RodeanAzari/riscv-rv32i-tmr-core/docs/reports/ila_coremark.csv

Sample in Buffer | Sample in Window | TRIGGER | g_ila.ex_mem_alu_result_p[31:0] | g_ila.ex_mem_instr_p[31:0] | g_ila.ex_mem_pc_p[31:0] | g_ila.halt_p | g_ila.id_ex_instr_p[31:0] | g_ila.id_ex_pc_p[31:0] | g_ila.if_id_instr_p[31:0] | g_ila.if_id_pc_p[31:0] | g_ila.mem_wb_instr_p[31:0] | g_ila.mem_wb_pc_p[31:0] | g_ila.wb_rd_addr_p[4:0] | g_ila.wb_rd_wdata_p[31:0] | g_ila.wb_rd_we_p
Radix - UNSIGNED | UNSIGNED | UNSIGNED | HEX | HEX | HEX | HEX | HEX | HEX | HEX | HEX | HEX | HEX | HEX | HEX | HEX
0 | 0 | 0 | 00004b78 | 00044783 | 00002574 | 0 | 00000013 | 00000000 | 0007a023 | 0000255c | fed796e3 | 00002570 | 0d | ffffffec | 0
1 | 1 | 0 | 00000000 | 00000013 | 00000000 | 0 | 0007a023 | 0000255c | 00072023 | 00002560 | 00044783 | 00002574 | 0f | 00004b78 | 0
2 | 2 | 0 | 00007e74 | 0007a023 | 0000255c | 0 | 00072023 | 00002560 | 00478793 | 00002564 | 00000013 | 00000000 | 00 | 00000000 | 1
3 | 3 | 0 | 00007e54 | 00072023 | 00002560 | 0 | 00478793 | 00002564 | 05010693 | 00002568 | 0007a023 | 0000255c | 00 | 00007e74 | 0
4 | 4 | 0 | 00007e78 | 00478793 | 00002564 | 0 | 05010693 | 00002568 | 00470713 | 0000256c | 00072023 | 00002560 | 00 | 00007e54 | 0
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
