RodeanAzari/riscv-rv32i-tmr-core/docs/reports/ila_capture.csv

Sample in Buffer | Sample in Window | TRIGGER | g_ila.ex_mem_alu_result_p[31:0] | g_ila.ex_mem_instr_p[31:0] | g_ila.ex_mem_pc_p[31:0] | g_ila.halt_p | g_ila.id_ex_instr_p[31:0] | g_ila.id_ex_pc_p[31:0] | g_ila.if_id_instr_p[31:0] | g_ila.if_id_pc_p[31:0] | g_ila.mem_wb_instr_p[31:0] | g_ila.mem_wb_pc_p[31:0] | g_ila.wb_rd_addr_p[4:0] | g_ila.wb_rd_wdata_p[31:0] | g_ila.wb_rd_we_p
Radix - UNSIGNED | UNSIGNED | UNSIGNED | HEX | HEX | HEX | HEX | HEX | HEX | HEX | HEX | HEX | HEX | HEX | HEX | HEX
0 | 0 | 0 | 00251f06 | 00178793 | 00000210 | 0 | 00f12623 | 00000214 | 00c12783 | 00000218 | 00178793 | 00000210 | 0f | 00007fcd | 0
1 | 1 | 0 | 00007fcc | 00f12623 | 00000214 | 0 | 00c12783 | 00000218 | fefb78e3 | 0000021c | 00178793 | 00000210 | 0f | 00251f06 | 1
2 | 2 | 0 | 00007fcc | 00c12783 | 00000218 | 0 | fefb78e3 | 0000021c | fefb78e3 | 0000021c | 00f12623 | 00000214 | 0c | 00007fcc | 0
3 | 3 | 0 | fffffff0 | fefb78e3 | 0000021c | 0 | fefb78e3 | 0000021c | 001c0c13 | 00000220 | 00c12783 | 00000218 | 0f | 00251f06 | 1
4 | 4 | 0 | fffffff0 | fefb78e3 | 0000021c | 0 | 001c0c13 | 00000220 | 00000013 | 00000000 | fefb78e3 | 0000021c | 11 | fffffff0 | 0
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
