RodeanAzari/riscv-rv32i-tmr-core/docs/img/vivado/phase-d/90-102.png

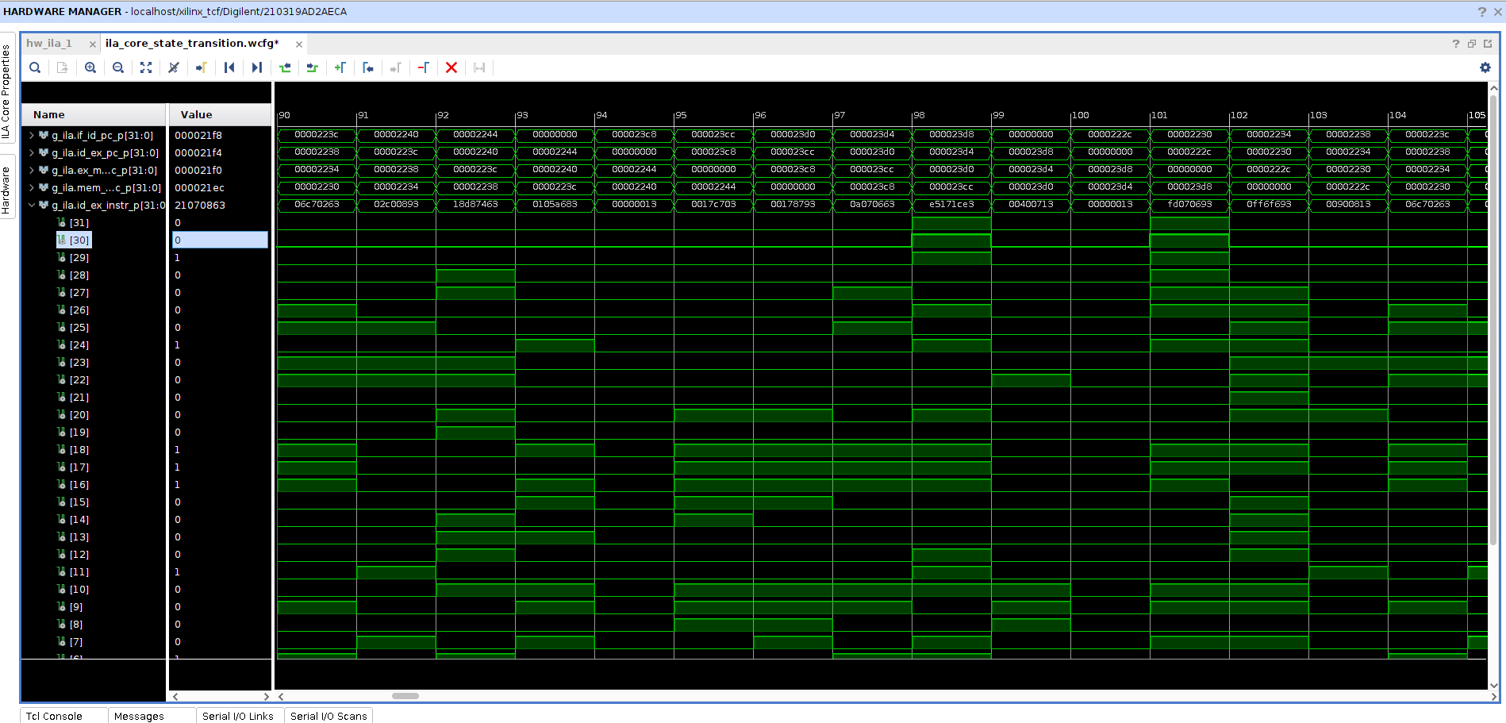
docs/img/vivado/phase-d/90-102.png
