RodeanAzari/riscv-rv32i-tmr-core/docs/img/vivado/phase-d/rtl-schematic-1.png

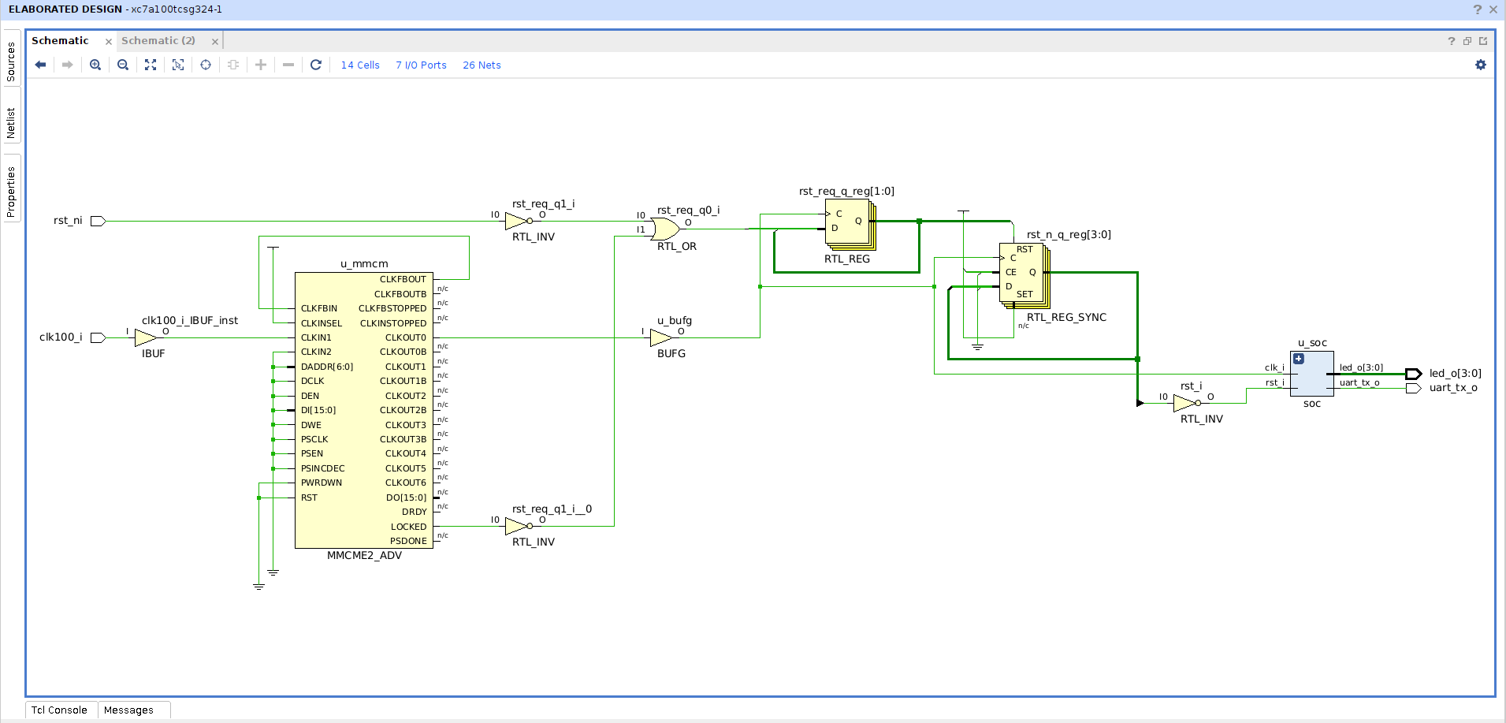
docs/img/vivado/phase-d/rtl-schematic-1.png
