RodeanAzari/riscv-rv32i-tmr-core/docs/img/vivado/phase-d/rtl-schematic-core-doubleclick.png

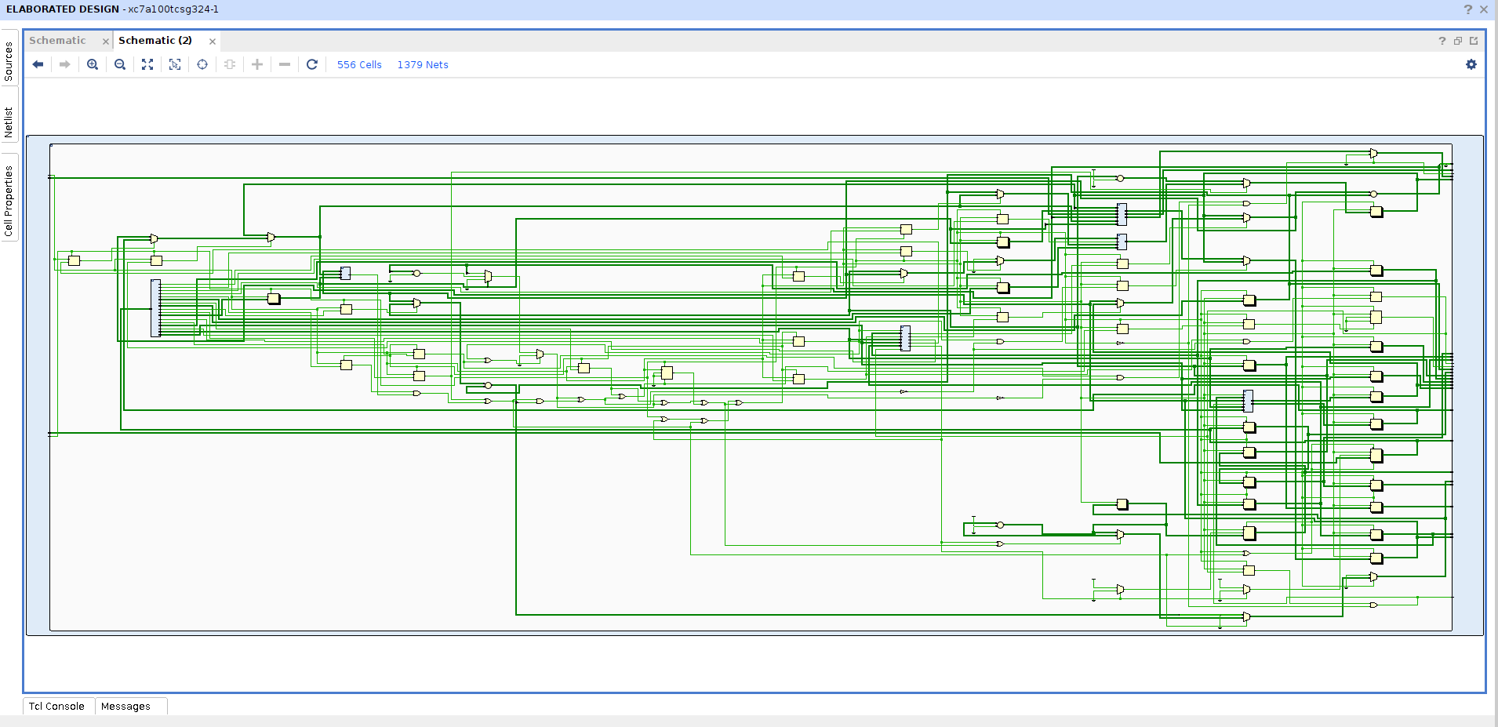
docs/img/vivado/phase-d/rtl-schematic-core-doubleclick.png
