RodeanAzari/riscv-rv32i-tmr-core/docs/img/vivado/phase-d/rtl-schematic-ram.png

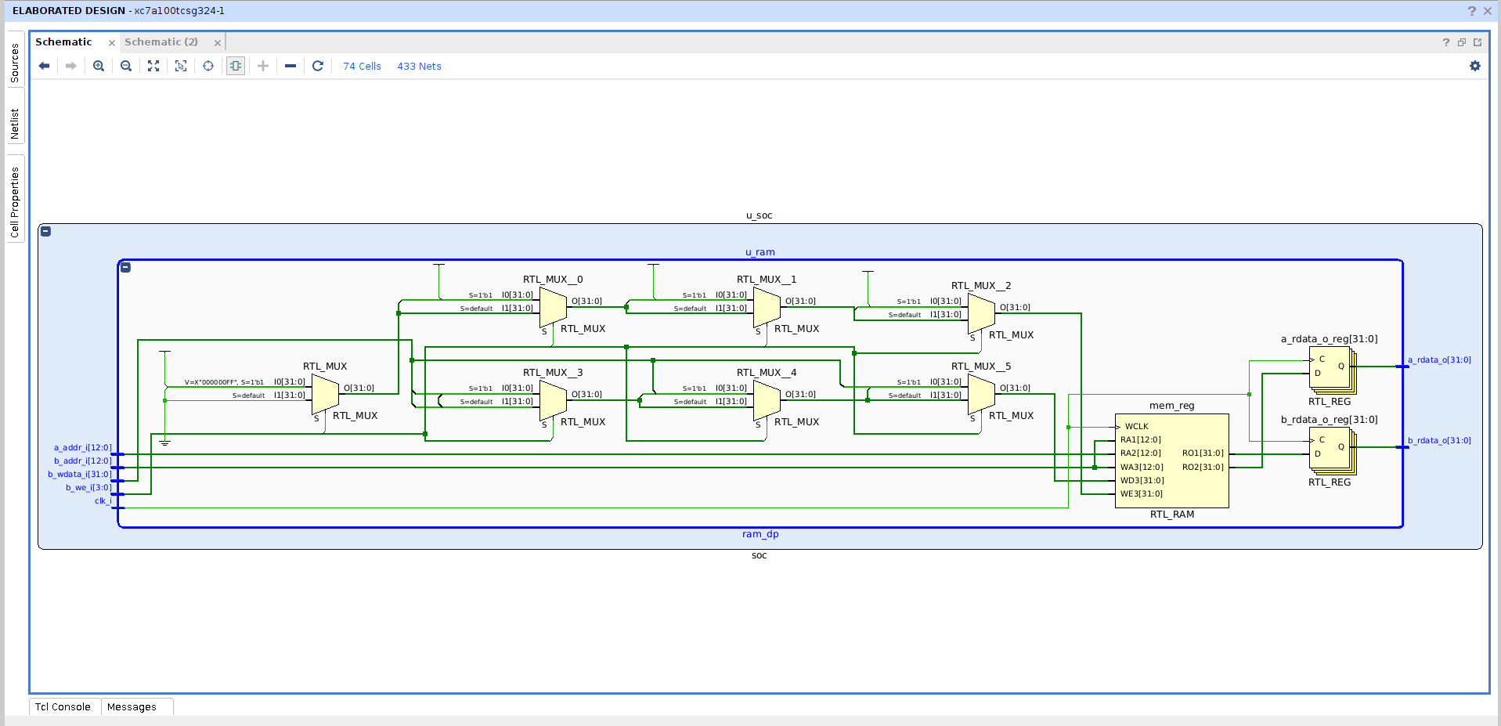
docs/img/vivado/phase-d/rtl-schematic-ram.png
