RodeanAzari/riscv-rv32i-tmr-core/docs/img/vivado/phase-d/rtl-schematic-u_soc.png

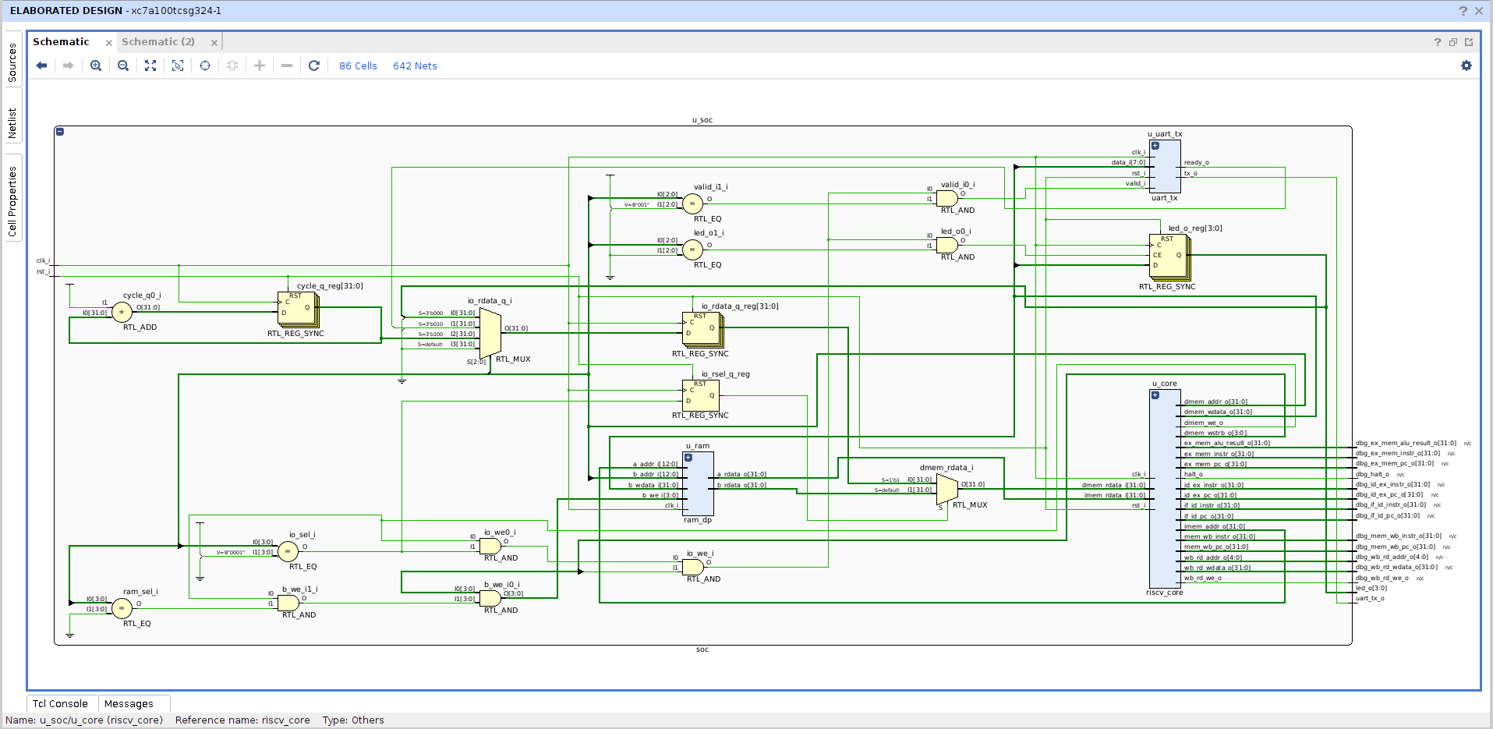
docs/img/vivado/phase-d/rtl-schematic-u_soc.png
