RodeanAzari/riscv-rv32i-tmr-core/docs/img/vivado/phase-d/utilization-summary.png

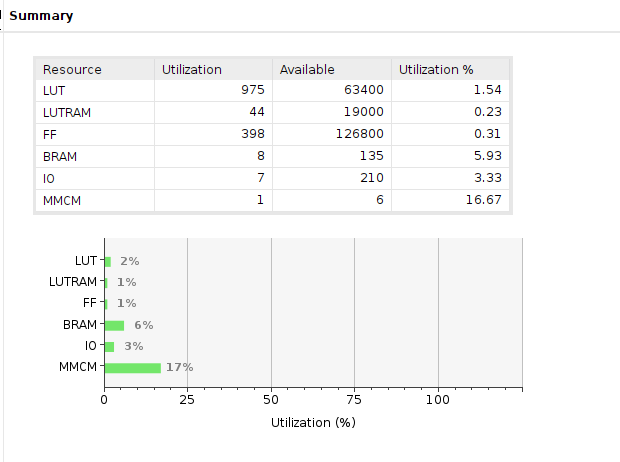
docs/img/vivado/phase-d/utilization-summary.png
