RodeanAzari/riscv-rv32i-tmr-core/docs/buildplan.md

# Build Plan

Reference spec for the project, moved out of `CLAUDE.md` so it is not loaded on
every request. **Section numbers are unchanged** (§5 to §8, plus the lists from
§9 and §10), because other docs cite them (§5.5, §6.4, §6.5...). Read the
relevant section when starting a phase; do not load the whole file.

## 5. Stage 1 specification

### 5.1 ISA

**RV32I base integer set**, 40 instructions:
- `LUI` `AUIPC` `JAL` `JALR`
- `BEQ` `BNE` `BLT` `BGE` `BLTU` `BGEU`
- `LB` `LH` `LW` `LBU` `LHU`
- `SB` `SH` `SW`
- `ADDI` `SLTI` `SLTIU` `XORI` `ORI` `ANDI` `SLLI` `SRLI` `SRAI`
- `ADD` `SUB` `SLL` `SLT` `SLTU` `XOR` `SRL` `SRA` `OR` `AND`
- `FENCE` `ECALL` `EBREAK`

**Out of scope:** M/A/F/D/C extensions, CSRs beyond a basic timer, MMU, privilege modes, interrupts.
*Changed 2026-10-22: the M extension is now planned for after Phase G (see Phase H), to speed up the tiny-LLM demo and Doom. A/F/D/C remain out of scope.*

### 5.2 Pipeline

Classic 5-stage in-order:

| Stage | Function |
|---|---|
| **IF** | PC update, instruction fetch from BRAM |
| **ID** | Decode, regfile read, immediate generation, hazard detection |
| **EX** | ALU, branch resolution, forwarding muxes |
| **MEM** | Data memory access, load/store alignment |
| **WB** | Regfile writeback |

**Branch resolution in EX.** Static not-taken prediction; flush IF/ID and ID/EX on taken.

### 5.3 Forwarding and hazards

Required paths:
- **EX→EX** (ALU result to next instruction's operand)
- **MEM→EX**
- **WB→ID** (regfile internal forwarding — write-first behaviour)

**Load-use hazard requires a one-cycle stall.** Forwarding cannot fix it because the load result isn't available until MEM. This is the single most commonly botched case — write directed tests for it before trusting random stimulus.

`x0` must always read zero regardless of writes.

### 5.4 RVFI interface (required for Phase B)

The core **must expose a RISC-V Formal Interface (RVFI) port** for `riscv-formal`. Design this in from Phase A — retrofitting it is painful.

Minimum signals: `rvfi_valid`, `rvfi_order`, `rvfi_insn`, `rvfi_trap`, `rvfi_halt`, `rvfi_intr`, `rvfi_rs1_addr`, `rvfi_rs2_addr`, `rvfi_rs1_rdata`, `rvfi_rs2_rdata`, `rvfi_rd_addr`, `rvfi_rd_wdata`, `rvfi_pc_rdata`, `rvfi_pc_wdata`, `rvfi_mem_addr`, `rvfi_mem_rmask`, `rvfi_mem_wmask`, `rvfi_mem_rdata`, `rvfi_mem_wdata`.

Emitted at the WB stage, one retirement per `rvfi_valid`.

### 5.5 Formal properties (Phase B)

Beyond riscv-formal's ISA compliance, hand-write SVA for:

- **Forwarding correctness** — forwarded value equals the architectural value the instruction should have read
- **No structural hazard** on regfile read/write ports
- **Branch flush correctness** — no wrong-path instruction ever reaches WB
- **Pipeline register validity** — no X propagation into committed architectural state
- **`x0` invariance** — reads as zero always
- **Stall correctness** — a stalled stage holds its value; no instruction is lost or duplicated

Run bounded model checking **and induction**. Check every property for **reachability** — a property that passes vacuously proves nothing. Record proof depth.

**Log every bug formal catches that simulation missed.** This is the highest-value artifact of the phase.

### 5.6 UVM environment (Phase C)

- Driver, monitor, scoreboard, coverage collector
- Golden ISA reference model (C++ or Python) via **DPI-C**
- Per-instruction architectural state comparison against the model
- Constrained-random instruction stream generation

**Functional coverage plan** (write it in `docs/` first, then close against it):
- All 40 instructions
- All forwarding paths, individually and in combination
- Load-use stall
- Branch taken / not-taken for each branch type
- Corner immediates (0, max positive, max negative, sign-extension boundaries)
- Back-to-back dependent instructions
- Memory alignment cases for each load/store width

**Target: ≥95% functional coverage.**

### 5.7 TMR (Phase E)

```
   ┌──────────────┐
──▶│  Core Copy A │──┐
   └──────────────┘  │
   ┌──────────────┐  │   ┌─────────────┐
──▶│  Core Copy B │──┼──▶│    VOTER    │──▶ output
   └──────────────┘  │   │  (2-of-3)   │
   ┌──────────────┐  │   └──────┬──────┘
──▶│  Core Copy C │──┘          │
   └──────────────┘             ▼
                          mismatch counter
```

- Vote on **architectural state**: regfile writes, PC, memory writes
- Expose a **mismatch counter** readable at runtime
- **Fault-injection harness** (testbench only, not synthesizable): flip random bits in regfile/pipeline registers at randomized cycles
- **Formally verify the voter**: any two agreeing inputs produce that output

Measure: fault detection rate, recovery rate, area overhead vs. baseline, Fmax penalty.

⚠ **Use `DONT_TOUCH` / `KEEP_HIERARCHY` on the three copies.** Vivado will otherwise merge identical logic and silently defeat the redundancy. Verify in the synthesis report that three copies actually exist.

---

## 6. Stage 2 specification

```
   ┌──────────────────┐        ┌──────────────────────────┐
   │  RISC-V CORE     │        │  SYSTOLIC ARRAY          │
   │  (Stage 1)       │        │  16×16 PE, INT8→INT32    │
   │  control code    │        │  weight-stationary       │
   └────────┬─────────┘        └────────────┬─────────────┘
            │ AXI4-Lite master              │ AXI4-Lite slave (ctrl)
            │                               │ AXI4 master (data)
   ┌────────▼───────────────────────────────▼─────────────┐
   │           AXI4 / AXI4-Lite INTERCONNECT              │
   │   round-robin arbiter · address decode · outstanding │
   └──────┬─────────────────┬─────────────────┬───────────┘
          │                 │                 │
   ┌──────▼──────┐  ┌───────▼──────┐  ┌───────▼────────┐
   │ DMA ENGINE  │  │ BRAM weights │  │ BRAM activations│
   │ descriptor  │  │  + scratchpad│  │  + results      │
   │ scatter-gath│  │              │  │                 │
   └─────────────┘  └──────────────┘  └─────────────────┘
```

### 6.1 Systolic array

**Weight-stationary**, 16×16 PE grid.

```
   weights preloaded into PEs and held
   activations stream left→right, partial sums flow top→bottom

   Each PE:  acc_out = acc_in + (w_stationary × a_in)
             a_out   = a_in   (registered, passes right)
```

| Parameter | Value | Rationale |
|---|---|---|
| Array size | 16×16 = 256 MACs | Parameterize it. 8×8 is the fallback. |
| Input precision | INT8 signed | — |
| Accumulator | INT32 | 16 terms × (±128)² ≈ 2^18; INT32 gives ample headroom |
| Dataflow | Weight-stationary | Simplest; good for GEMM with weight reuse |

**DSP budget.** 256 MACs vs. 240 DSP48E1. Two INT8 multiplies can be packed into one DSP48E1 by placing two 8-bit operands in the 25-bit A port with sufficient guard bits (see Xilinx WP487 — written for DSP48E2, adapt for the 25×18 DSP48E1).

**Verify packing empirically.** Check the synthesis report for actual DSP count. If Vivado maps MACs to LUT fabric instead, either restructure the code or instantiate `DSP48E1` explicitly. **If packing doesn't work out, drop to 8×8 rather than fighting it** — a working 8×8 with honest numbers beats a broken 16×16.

**Data feeding is the real problem.** A 16×16 array consumes 16 activations per cycle. Document BRAM banking and how the array stays fed. **Report measured PE utilization, not peak theoretical GOPS.** An honest 40% with an explanation is a better answer than a peak figure that can't be defended.

Also specify: edge handling for matrices not a multiple of 16 (zero-pad vs. partial-tile control), and output requantization (scale, saturation, rounding mode).

### 6.2 AXI interconnect

- **AXI4-Lite** for control registers (core → accelerator, core → DMA)
- **AXI4** for data movement
- Round-robin arbitration, address decode, outstanding-transaction tracking

**SVA protocol assertions required:**
- `VALID` must not deassert before `READY` (handshake stability)
- Address/data stable while `VALID` high and `READY` low
- No `READY`/`VALID` combinational dependency loop (deadlock freedom)
- Outstanding transaction count never exceeds the configured limit
- Write response follows write data

### 6.3 DMA engine

Descriptor-based with scatter-gather. **The register map and descriptor format are [DMA-Engine](https://github.com/RodeanAzari/DMA-Engine)'s** (submodule `sw/dma-engine/`, `spec/dmaeng.yaml`), so the driver built there against its QEMU model matches this RTL. That replaces the linked list first planned here (descriptors with a next pointer): descriptors sit in a power-of-two ring (32 bytes each: source, destination, length, flags with OWN/IRQ/LAST, status); the driver advances TAIL (the doorbell), the engine walks HEAD to TAIL, writes status before clearing OWN, and stops on an error until `CTRL.RESET`. Scatter-gather is a run of descriptors closed by `LAST`. Behaviour follows `qemu-device/dmaeng.c`; `traces/dmaeng-sync.trace` is golden stimulus.

On this SoC: addresses are 32 bits, so `RING_BASE_HI` and the descriptors' upper address words must be 0 (anything else fails as an unmapped access, `DMA_FAIL`). The core has no interrupts: `IRQ_STATUS`/`IRQ_MASK` and the interrupt output exist as specified, and software polls OWN or HEAD.

> **Design note:** this DMA is reused later for a PCIe host bridge. **Separate the descriptor/scatter-gather logic from the transport layer** so only the transport changes. Do not entangle AXI specifics into the descriptor engine.

### 6.4 ASIC flow (LibreLane + Sky130)

Not a separate project — it runs on this repo's RTL and its results belong in this README.

**LibreLane, not OpenLane.** LibreLane is the FOSSi Foundation's continuation of
Efabless's OpenLane 2; after Efabless wound down, OpenLane 2 went quiet and the original
OpenLane became the legacy flow. Same underlying tools (Yosys, OpenROAD, Magic, Netgen,
KLayout), same Sky130 PDK, same steps below. Older docs and tutorials say "OpenLane" —
read them as background, not as install or config instructions.

**This section spans both stages.** It sits in §6 to keep the ASIC story in one place,
but run #1 is a **Phase E deliverable and therefore part of Stage 1** — it is a checkbox
in Phase E's definition of done, so Stage 1 is not complete until it has been done.

**Run it twice:**

| Run | When | Input |
|---|---|---|
| **1** | Closing Phase E | Stage 1 bare core, non-TMR variant (smaller, simpler) |
| **2** | During Phase H | Full Stage 2 SoC with accelerator, DMA, AXI |

The **comparison between the two runs** is the interesting result — how area, congestion, and timing closure change when an accelerator and a bus fabric are added. That feedback loop (physical results informing RTL decisions) is more valuable than either run alone.

**Flow steps:**
1. Synthesis (Yosys)
2. **Scan chain insertion** (§6.5)
3. Floorplanning
4. Placement
5. Clock tree synthesis
6. Routing
7. STA signoff
8. DRC / LVS clean
9. GDSII output

**Report per run:** die area (µm²), cell count, utilization %, post-layout Fmax vs. pre-synthesis estimate, power estimate, DRC/LVS clean confirmation, layout screenshot.

Also write a short FPGA-vs-ASIC comparison for the same RTL — the two targets have very different cost models and saying why is a good interview answer.

### 6.5 Scan chain insertion (DFT)

Small addition during Phase H — budget 2–3 days.

**Achievable with free tools:**
- Scan chain insertion via Yosys/LibreLane — convert flops to scan flops, stitch chains.
  **Unverified:** whether LibreLane has a built-in scan-insertion step. Check before
  budgeting Phase H around it.
- Scan shift verification in simulation
- Report chain count, chain length, test coverage, area and timing overhead vs. non-scan

**Not achievable — do not attempt:** MBIST generation, commercial ATPG (Tessent, TetraMAX), SSN, boundary scan insertion. All require licensed tools.

**Framing:** "inserted and verified scan chains in an open-source ASIC flow, with coverage and area overhead reported" is truthful. It is not production DFT experience — don't claim it is.

---

## 7. Out of scope — do not build these

Hard boundaries. If a task seems to require one of these, stop and flag it rather than expanding scope.

**Stage 1:**
- Out-of-order execution / Tomasulo *(architecturally incoherent with TMR — rad-hard designs are deliberately simple, in-order, deterministic)*
- Superscalar issue
- Cache hierarchy beyond simple BRAM IMEM/DMEM
- MMU, privilege modes, interrupt controller
- Branch prediction *(optional extension only after Phase E ships, and then only with measured IPC deltas)*

**Stage 2:**
- Full mesh NoC *(the AXI interconnect is the interconnect story — say "AXI interconnect," never "NoC")*
- Training hardware, backward passes, ML framework integration
- BF16 *(only if Phases F–H finish early, and only after INT8 is complete and measured on hardware)*

**After the project — the Doom finale.** Once Phase H is done and every box in
§8 is checked, and not before: build what the SoC lacks to play Doom on the
Arty. Everything below is out of scope until then.
- **Memory:** the 256 MB DDR3 through Xilinx's MIG on the AXI interconnect,
  with a cache in front of it (Doom needs a few MB; block RAM is ~600 KB)
- **The game data:** the shareware WAD (~4 MB) read from the Arty's 16 MB
  QSPI flash, or copied into DDR at boot
- **Video:** a framebuffer and VGA timing in RTL, out through a VGA Pmod
  (the Arty has no video output)
- **Input and time:** keys over the UART; the cycle counter as the clock
- **Speed:** the M extension (Doom's fixed-point math multiplies constantly),
  measured as frames per second with and without it (M itself is built in
  Phase H, see there)

---

## 8. Phase definitions of done

A phase is done when **every** box is checked. No partial credit.

### Phase A — Working core
- [x] All 40 RV32I instructions implemented
- [x] All forwarding paths working; load-use stall correct
- [x] RVFI port exposed and populated
- [x] Official `riscv-tests` RV32I suite passes
- [x] `make lint` clean, `make sim` passes in CI

### Phase B — Formal verification
- [x] `riscv-formal` ISA compliance passing
- [x] All §5.5 hand-written properties written and proven
- [x] Induction runs, not just BMC
- [x] Reachability checked for every property (no vacuous passes)
- [x] `docs/formal-properties.md` lists every property, proof depth, and result
- [x] Bugs formal found that simulation missed are logged

### Phase C — UVM environment
- [ ] Driver, monitor, scoreboard, coverage collector implemented
- [ ] DPI-C golden model comparing per-instruction architectural state
- [ ] Constrained-random instruction generation
- [ ] `docs/coverage-plan.md` written
- [ ] ≥95% functional coverage achieved

### Phase D — Hardware bring-up
- [x] Synthesizes and meets timing; Fmax documented
- [x] UART peripheral working
- [x] Compiled C program boots and prints over UART
- [x] Dhrystone or CoreMark runs; IPC measured
- [x] ILA probes on pipeline registers
- [x] Timing + utilization reports committed to `docs/`
- [x] Photo/video of the board running

### Phase E — TMR + fault injection
- [x] Three copies + voter; `DONT_TOUCH` verified in synthesis report
- [x] Fault-injection harness with randomized bit flips
- [x] Voter formally verified
- [x] Fault detection rate, recovery rate measured over a documented campaign size
- [x] Area overhead and Fmax penalty vs. baseline recorded
- [x] **LibreLane run #1** on the non-TMR core: area, post-layout Fmax, power, DRC/LVS clean, layout screenshot (§6.4)

**→ Stage 1 complete. Update README with all results before starting Phase F.**

### Phase F — Systolic array
- [x] Single PE verified exhaustively
- [x] Python/NumPy GEMM golden model written **before** the RTL
- [x] 4×4 working, then parameterized to 16×16 (or 8×8 if DSP packing fails)
- [x] Bit-exact match against golden model across thousands of random matrices
- [x] Edge cases: non-multiple-of-16 matrices, saturation boundaries
- [x] Synthesis report confirms expected DSP usage

### Phase G — DMA + interconnect
- [x] AXI4-Lite control interface
- [x] AXI4 data interface
- [x] Descriptor-based DMA with scatter-gather, to DMA-Engine's spec (§6.3): register package generated from `spec/dmaeng.yaml` and checked against it, a Python model ported from `qemu-device/dmaeng.c` first, `traces/dmaeng-sync.trace` replayed against the RTL, and a bare-metal driver on the core using `dmaeng_regs.h`
- [x] Interconnect with round-robin arbitration and address decode
- [x] All §6.2 SVA assertions written and passing (proven on the crossbar, `tb/formal/axi_xbar.sby`; the DMA's own AXI ports are protocol-checked in simulation, `tb/cocotb/axi_mem.py`)
- [x] Software on the core configures and launches an accelerator job (`sw/apps/gemmtest.c` through `sw/lib/gemm.c`: the DMA fills the accelerator's buffers, the core starts the job and polls; `soc:test_gemm`, C checked against the golden model, job cycles equal to the model's)
- [x] Release `soc-v1.0` (fpga-coord §5: release test, `CHANGELOG.md`, annotated tag; evidence `docs/reports/release_soc-v1.0.txt`); P4 waits on it

### Phase H — Integration + DFT
- [ ] M extension (RV32IM), first thing after Phase G: a parameter defaulting to off so every Stage 1 result stays valid for RV32I; riscv-formal M checks, UVM golden model + coverage, TMR, CoreMark, synth trend rerun with RV32IM in their own rows
- [ ] Array clock domain (P5 and P7 depend on it): `clk_array` from its own MMCM output, defaulting to the core clock; async FIFOs for data, pulse or handshake synchronizers for control and status, a reset synchronizer in `clk_array`; `set_clock_groups -asynchronous` in the XDC; Vivado `report_cdc` shows no unsafe crossings
- [ ] Weight-transform stage in the weight-load path, identity by default, the array itself untouched
- [ ] MMCM DRP behind core-accessible registers: software changes `clk_array` at runtime (part of `soc-v2.0`, which P5 and P7 wait on)
- [ ] End-to-end on hardware: C program loads weights via DMA, launches GEMM, reads results
- [ ] Full regression and the hardware GEMM test pass with `clk_array` at a different frequency from the core (e.g. 80 MHz vs. 100 MHz)
- [ ] Benchmarked against software matmul on the same core, several matrix sizes
- [ ] Measured PE utilization reported
- [ ] Scan chain insertion; chain count, coverage, area overhead reported (§6.5)
- [ ] **LibreLane run #2** on the full SoC (§6.4)
- [ ] Written comparison of run #1 vs. run #2 — how area, congestion, and timing changed
- [ ] Written FPGA-vs-ASIC comparison for the same RTL (§6.4)
- [ ] Release `soc-v2.0` (fpga-coord §5); P4, P5 and P7 wait on it

---

## 9 (Stage 2). Known failure modes, Stage 2

- **Building the array before the golden model** — you cannot distinguish a dataflow bug from an indexing bug without a reference.
- **Underestimating the feeding problem** — if memory can't supply 16 activations/cycle, utilization collapses and GOPS figures become fiction.
- **DSP inference failure** — Vivado silently mapping MACs to LUTs. Check the synthesis report.
- **AXI handshake deadlock** — ready/valid dependency loops. Write the assertions before debugging on hardware.
- **Accumulator overflow unnoticed** because random test matrices have small values. Include adversarial saturation cases.

---

## 10 (metrics). Metrics to record in README

The README is the deliverable: an architecture diagram and a results table with
real numbers. The measurement rules are in `CLAUDE.md` §10.

**Stage 1**
- Fmax (MHz) on Artix-7
- Utilization: LUTs, FFs, BRAM, DSP, and % of device
- CPI / IPC on Dhrystone and CoreMark
- Formal: properties proven, proof depth, bugs found that simulation missed
- Functional coverage %
- TMR: fault detection rate, recovery rate, area overhead %, Fmax penalty

**Stage 2**
- GOPS (INT8) at achieved Fmax
- **Measured** PE utilization % (not peak theoretical)
- Speedup vs. software matmul, across several matrix sizes
- DSP slices used vs. LUT-fabric MACs
- AXI: outstanding depth, measured throughput
- SVA properties proven on AXI interfaces
- LibreLane **both runs**: die area, post-layout Fmax, power — and the delta between bare core and full SoC
- Scan chain count, coverage %, area overhead

**Also in the README:** architecture diagram (image, not ASCII), hardware photo or ILA capture, and build/run instructions.

---
