RodeanAzari/riscv-rv32i-tmr-core/docs/img/vivado/phase-d/rtl-schematic-hazard.png

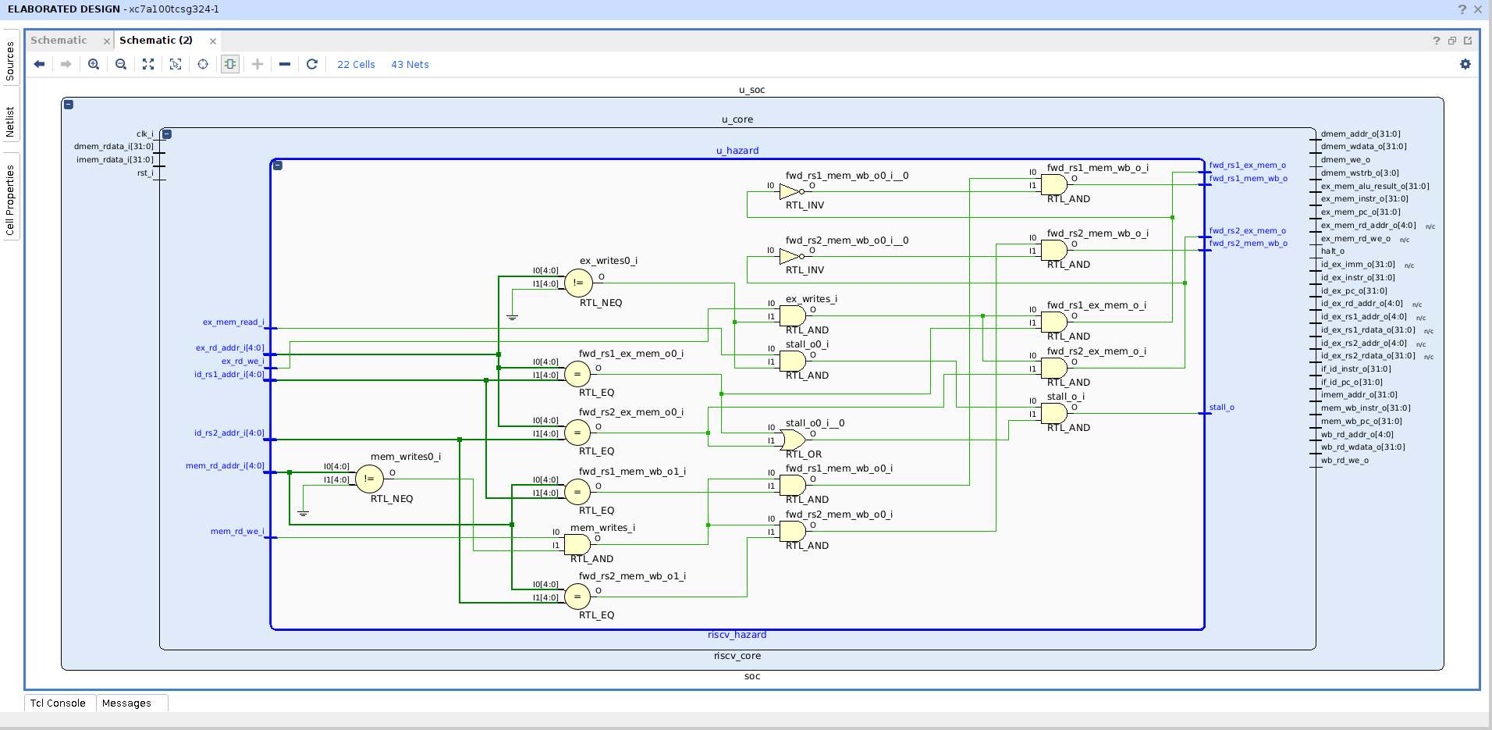
docs/img/vivado/phase-d/rtl-schematic-hazard.png
