RodeanAzari/riscv-rv32i-tmr-core/sw/coremark-port/core_portme.h

/* CoreMark port for the first-light SoC (rtl/top/soc.sv): bare metal, RV32I,
 * no floating point, no libc. Derived from EEMBC's barebones port
 * (sw/coremark/barebones/core_portme.h, Apache-2.0); the benchmark's own
 * files are compiled unmodified, as CoreMark's run rules require.
 *
 * Time is the SoC's cycle counter, so a "tick" is one core clock cycle and
 * CoreMark/MHz is iterations * 10^6 / ticks, independent of the clock the
 * board runs at. CLK_HZ only converts ticks to seconds for CoreMark's own
 * report (and its 10-second validity check).
 */
#ifndef CORE_PORTME_H
#define CORE_PORTME_H

#include <stddef.h>

#ifndef CLK_HZ
#define CLK_HZ 100000000u                /* the core clock on the Arty A7 */
#endif

#define HAS_FLOAT  0
#define HAS_TIME_H 0
#define USE_CLOCK  0
#define HAS_STDIO  0
#define HAS_PRINTF 0

#ifndef COMPILER_VERSION
#define COMPILER_VERSION "GCC" __VERSION__
#endif
#ifndef COMPILER_FLAGS
#define COMPILER_FLAGS FLAGS_STR         /* from the Makefile */
#endif
#define MEM_LOCATION "STATIC"

typedef signed short   ee_s16;
typedef unsigned short ee_u16;
typedef signed int     ee_s32;
typedef int            ee_f32;           /* unused: HAS_FLOAT is 0 */
typedef unsigned char  ee_u8;
typedef unsigned int   ee_u32;
typedef ee_u32         ee_ptr_int;
typedef size_t         ee_size_t;

#define align_mem(x) (void *)(4 + (((ee_ptr_int)(x)-1) & ~3))

#define CORETIMETYPE ee_u32
typedef ee_u32 CORE_TICKS;

#define SEED_METHOD SEED_VOLATILE
#define MEM_METHOD  MEM_STATIC

#define MULTITHREAD       1
#define USE_PTHREAD       0
#define USE_FORK          0
#define USE_SOCKET        0
#define MAIN_HAS_NOARGC   1
#define MAIN_HAS_NORETURN 0

extern ee_u32 default_num_contexts;

typedef struct CORE_PORTABLE_S
{
    ee_u8 portable_id;
} core_portable;

void portable_init(core_portable *p, int *argc, char *argv[]);
void portable_fini(core_portable *p);

#if !defined(PROFILE_RUN) && !defined(PERFORMANCE_RUN) \
    && !defined(VALIDATION_RUN)
#if (TOTAL_DATA_SIZE == 1200)
#define PROFILE_RUN 1
#elif (TOTAL_DATA_SIZE == 2000)
#define PERFORMANCE_RUN 1
#else
#define VALIDATION_RUN 1
#endif
#endif

int ee_printf(const char *fmt, ...);

#endif /* CORE_PORTME_H */
