RodeanAzari/riscv-rv32i-tmr-core/(commit log)

2026-09-04 Add PC and IF stage with cocotb regression
    First slice of Phase A. The core drives imem_addr and captures imem_rdata
    one cycle later, matching BRAM read timing on the Arty A7; IF/ID resets to
    a NOP so ID never sees X on the first cycle.
    Three cocotb tests cover reset state, PC sequencing, and IF/ID capture.
    Replaces the empty rtl/MAIN.sv placeholder.
    Claude-Session: https://claude.ai/code/session_01NBXMMrAveEU5QAWb5kGGgA
    [riscv_core.sv]
2026-09-04 Run the cocotb regression in CI
    apt ships Verilator 5.020, below cocotb 2.x's 5.036 floor, so CI builds
    5.050 from source and caches it on the version key. Only the first run
    after a version bump pays the compile cost.
    tb/Makefile now falls back to a system cocotb when ~/cocotb-env is absent,
    which is the case on a runner. cocotb version pinned in tb/requirements.txt
    to match the local venv.
    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
2026-09-05 Add out-of-context synthesis flow and Vivado 2025.2 setup
    make synth runs synthesis and implementation of riscv_core on its own,
    writing committed reports to docs/reports/.
    Out-of-context because the core's ports (imem_*, if_id_*) are internal
    signals that will connect to BRAM and downstream stages, not package
    pins. OOC skips I/O buffer insertion and pin constraints, so the core
    can be measured before a board-level top exists. The run goes all the
    way through route_design: post-synthesis timing is an estimate, since
    Vivado is guessing routing delay, and post-route is measured.
    Baseline on xc7a100tcsg324-1, PC and IF only:
    WNS +7.338 ns against a 10 ns constraint -> Fmax 375.7 MHz
    2 L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
2026-09-05 Make per-increment measurement a standing practice
    The synthesis baseline was recorded as a one-off snapshot, which is the
    wrong shape for something whose value is the trend. Replace it with an
    append-only table in docs/PROGRESS.md, one row per RTL slice, and state
    explicitly that it is the single exception to that file's
    snapshot-not-diary rule.
    Record the practice itself in CLAUDE.md section 1.3 so it survives into
    future sessions rather than living in one conversation:
    - measure every increment, not just the finished thing, because a table
    of what each stage cost in MHz and LUTs localises regressions and is a
    better interview answer than a single end-of-project figure
    - numbers are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
2026-09-17 Convert reset to synchronous active-high and suffix ports _i/_o
    CLAUDE.md section 4 requires a synchronous, active-high reset and _i/_o
    port suffixes. The core was written with async active-low rst_n and bare
    port names, so both moved.
    Done now because reset and naming conventions are viral: every module,
    testbench and the Phase E TMR wrapper inherits them. Seven lines today,
    every file in rtl/ by Phase E.
    Verified in the synthesis report rather than assumed. The 92 flops went
    FDCE/FDPE (async clear/preset) to FDRE/FDSE (sync reset/set), and one of
    the two LUT1s disappeared with the active-low inverter that had been
    feeding the SR pins. 89 reset plus 3 set because the IF/ID register holds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
    [riscv_core.sv]
2026-09-17 Move to the nested layout and make every source glob recursive
    CLAUDE.md section 3 specifies rtl/core, tb/cocotb and friends. riscv_core.sv
    and test_core.py move into place; the other eight directories are not
    created, because an empty directory is speculative structure and each one
    can appear when it has a file to hold.
    The move is the small part. The real problem was that every source glob
    matched exactly one level, and the two toolchains fail differently on a
    file the glob misses: Verilator errors out, but Vivado black-boxes the
    missing module with a critical warning and completes, emitting a
    utilization report for a design with a hole in it. That number would then
    be transcribed into th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
    [riscv_core.sv]
2026-09-17 Reconcile the docs with the rewritten two-stage spec
    The CLAUDE.md rewrite doubled the scope (Stage 2: systolic array, DMA,
    AXI, plus an OpenLane run) and added coding standards, phase definitions
    of done and a hardware target table. Several things around it were left
    saying something different.
    CLAUDE.md:
    - status table said Phase A NOT STARTED while PROGRESS.md and the
    committed reports said otherwise; now IN PROGRESS with its numbers
    - cocotb was listed as a Stage 2 tool; it has been the whole regression
    since the first commit
    - required-target list now says which phase each target lands in, and
    why synth routes rather than stopping at synthesis while impl is the
    se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
2026-09-17 Pin cocotb 2.1.0: 2.0.1 segfaults on a design with a register array
    Adding the register file made reading a top-level output port segfault
    inside the VPI layer. Not an assertion failure -- a crash.
    Reduced to a 15-line module with one 32x32 array and twelve 32-bit
    outputs. On cocotb 2.0.1, 4 of 12 port reads succeed and the crash point
    moves when unrelated build flags change, which is memory corruption
    rather than a logic error. On 2.1.0, 12 of 12.
    Ruled out before blaming the tool: our RTL (lint clean, and Verilator's
    generated C++ is symmetric across the ports -- 14 occurrences each),
    signal naming, port count (12 outputs with no array are fine), packed
    versus unpacked array (both crash)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
2026-09-17 Add the ID stage: decoder, register file, and ID/EX
    Second slice of Phase A. Fetch now feeds a real decode stage.
    rtl/core/riscv_decoder.sv -- register addresses and all five RV32I
    immediate formats. Decodes only what ID consumes; ALU, memory and
    writeback control arrive with the stages that consume them, because a
    control signal with no destination is dead logic that lint cannot tell
    apart from a mistake.
    rtl/core/riscv_regfile.sv -- 32 x 32, two read ports, one write port.
    x0 invariance and WB->ID write-first forwarding live here rather than in
    the surrounding pipeline, because both are formal properties (5.5) and
    the register file is where they can be proven in isolation. The x0 check
    s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
    [riscv_core.sv, riscv_decoder.sv, riscv_regfile.sv]
2026-09-17 Add the EX stage: ALU, operand selection, and EX/MEM
    Third slice of Phase A. Decode now feeds a real execute stage.
    Scope, and why it stops where it does. Branches and jumps are out because
    branch resolution pairs with the flush machinery, which pairs with the
    hazard unit, and half a branch is worse than none. Loads and stores are
    out because they need MEM. EX->EX and MEM->EX forwarding are out because
    their sources are the EX/MEM and MEM/WB registers -- there is nothing
    downstream to forward from yet.
    Instructions in those classes decode inert (rd_we = 0) rather than
    half-working. That is deliberate: an instruction that writes a
    plausible-looking value is exactly the fault riscv-formal la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
2026-09-17 Record the current position and plan the MEM + WB slice
    Session handoff. Adds an explicit "you are here" to PROGRESS.md -- three
    of five pipeline stages built, results parking in EX/MEM with nothing
    writing back yet, and which instructions actually work today -- so the
    next session does not have to re-derive it from the RTL.
    Expands "Next up" into a plan that can be picked up cold. MEM + WB is
    written out in full: the external BRAM-shaped data memory port, why
    load/store alignment is the real work rather than the pipeline register,
    the decoder and EX/MEM additions it needs, and the fact that the
    temporary wb_rd_*_i ports get deleted from the interface when WB wires
    the register file write p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
2026-10-07 Add MEM and WB: data memory port, load/store alignment, writeback
    Fourth slice of Phase A, and the one that closes the loop: results now
    write back to the register file, and the core executes straight-line
    programs end to end, including all eight loads and stores.
    Misaligned accesses: assumed not to happen. RV32I requires support or a
    trap; traps are out of scope (5.1), and hardware support means a MEM
    FSM and a stall before any hazard unit exists. The behaviour is defined
    rather than undefined -- address bits below the access size are ignored,
    so a misaligned access touches the aligned word or halfword containing
    it -- and pinned by a test. Open for Phase B: what riscv-formal's
    RISCV_FORMA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
    [riscv_core.sv, riscv_decoder.sv, riscv_mem_align.sv]
2026-10-07 Fix IF timing: drive IMEM from pc_next, and BRAM-time the testbench
    Found during the MEM + WB slice. A BRAM latches its address at a clock
    edge and answers during the following cycle. The core presented pc, so
    the BRAM returned mem[P] while the pc register already held P + 4, and
    every instruction reached IF/ID tagged with the next instruction's PC --
    auipc x5, 0 at pc 8 wrote 12. Only auipc reads the PC today, but
    branches and JAL are next.
    The fix presents pc_next (the reset vector during reset), so the BRAM
    and the pc register latch the same address on the same edge. Branch
    redirect and the stall both enter at pc_next, so one mux will feed both.
    The alternative -- keep the address regist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
    [riscv_core.sv]
2026-10-07 Add the hazard unit: operand forwarding and the load-use stall
    First half of Phase A's "branches, jumps and hazard unit" item. Data
    hazards land now; branches follow as their own slice, since forwarding
    does not depend on control flow and branches bring the flush logic.
    Two slices also give two synthesis rows, so each cost shows alone.
    Golden model first (11): tb/cocotb/rv32i_model.py is an unpipelined,
    spec-written RV32I model. Random programs drawn from x0-x4, so nearly
    every instruction depends on a recent one, are compared against it.
    Proven on both sides: padded programs pass on the old core (model is
    right), dense programs fail on it at writeback #11 (test sees hazards),
    and both pass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
    [riscv_core.sv, riscv_hazard.sv]
2026-10-07 Add branches, JAL and JALR: resolution in EX, flush, link in EX
    Second half of Phase A's "branches, jumps and hazard unit" item. 37 of
    the 40 RV32I instructions now execute; FENCE, ECALL and EBREAK still
    decode inert.
    Static not-taken prediction, resolved in EX (5.2). A taken branch or
    jump puts its target on pc_next -- the pc and the IMEM BRAM latch it on
    the same edge -- and loads NOPs into IF/ID and ID/EX, the two younger
    words already fetched. Taken costs exactly two cycles, not taken none;
    both are measured by a timed test.
    Golden model first (11): rv32i_model.py gained branches, JAL and JALR.
    Its B/J immediate decode was checked against GNU as, an encoder
    independent of this repo --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
    [riscv_branch.sv, riscv_core.sv, riscv_decoder.sv]
2026-10-07 Clear only ID/EX's five control bits in a bubble
    Timing lever 1. The branch slice left the critical path ending in the
    flush: redirect drove the synchronous-reset pins of all 171 ID/EX flops.
    A bubble only has to be inert, and only five fields can act -- rd_we,
    mem_read, mem_write, branch, jump. Every other field is consumed only
    under one of them, so a bubble now holds the squashed instruction's
    data, which computes a result nothing writes. rst_i still resets all of
    ID/EX, so cycle one stays X-free. Cost: id_ex_pc_o / id_ex_instr_o show
    the squashed instruction during a bubble; RVFI's valid bit must tell
    bubbles apart anyway.
    Measured: the endpoint fanout fell 171 -> 5 and that net 1.06 ->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
    [riscv_core.sv]
2026-10-07 Decide forwarding selects in ID and register them into ID/EX
    Timing lever 2. After lever 1, ~5.1 ns of the 9.2 ns critical path was
    the forwarding decision -- rd compare, select, mux -- in series ahead
    of the branch comparator and the ALU.
    riscv_hazard now compares ID's rs1/rs2 against the rd of ID/EX and
    EX/MEM, and the core registers the four one-hot selects into ID/EX, so
    EX's forwarding muxes switch off flops. Exact, not speculative: stages
    past ID never hold, so ID/EX's instruction is in EX/MEM next cycle and
    EX/MEM's is in MEM/WB. When ID does not advance (stall, redirect) the
    selects land in a bubble, which acts on nothing, and ID decides again
    next cycle. The EX/MEM select a load-us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
    [riscv_core.sv, riscv_hazard.sv]
2026-10-07 Add the RVFI port under RISCV_FORMAL, checked against the golden model
    The CLAUDE.md 5.4 port, all nineteen fields, as rvfi_*_o, one record per
    retired instruction in WB. Phase A's "RVFI port exposed and populated".
    Valid bit: IF/ID's word is valid unless reset or a redirect squashed it,
    and holds through a stall; ID/EX's is cleared by every bubble; past ID
    it rides along. Reset NOPs, load-use bubbles and flushed words never
    retire. Fields are captured where they are born and ride shadow
    registers to WB: rs1/rs2 values at the forwarding mux outputs (the
    plan's "one that bites"), pc_wdata as redirect ? target : pc + 4 in
    EX, memory fields lane-style in MEM -- word address, byte masks, data
    i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
    [riscv_core.sv]
2026-10-08 Record the formal toolchain: OSS CAD Suite 2026-10-07
    Installed in ~/.local/opt/oss-cad-suite (no root), bin/ appended to
    PATH: Yosys 0.69+208, SymbiYosys 0.69, Yices 2.7.0, Boolector 3.2.4,
    Bitwuzla 0.9.1, Z3 4.15.5. The nightly's date is its version; CI pins
    the same date when formal joins it.
    Appended, not prepended or sourced: the suite ships its own Verilator
    and Python, which would silently replace the pinned Verilator 5.050 and
    cocotb's Python -- Vivado's settings64.sh lesson again. Verified:
    verilator and python3 still resolve to ~/.local/bin and /usr/bin.
    apt was checked first: Ubuntu 26.04 packages yosys 0.52 and boolector
    but no SymbiYosys and no Yices.
    Yosys reads the core: re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
2026-10-08 Rename the ASIC flow from OpenLane to LibreLane
    CLAUDE.md named "OpenLane" from before the ecosystem moved. Checked on
    GitHub 2026-10-07: The-OpenROAD-Project/OpenLane is the legacy flow
    (last push 2026-03); Efabless's OpenLane 2 now sits at
    chipfoundry/openlane2, quiet since 2025-12; librelane/librelane calls
    itself the successor, is based on OpenLane 2, is run by the FOSSi
    Foundation, and released 3.0.16 on 2026-10-06.
    Same tools (Yosys, OpenROAD, Magic, Netgen, KLayout) and the same
    Sky130 PDK underneath, so 6.4's steps and metrics are unchanged.
    Renamed now, before anything is installed, so no one follows a stale
    spec to the wrong flow: CLAUDE.md (2, 6.4, 8, 10), the make asic stub,
    REA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
2026-10-08 Halt on ECALL and EBREAK; FENCE is a NOP
    RV32I says ECALL and EBREAK trap. Traps need mtvec/mepc/mcause and the
    CSR instructions, all out of scope (5.1), so the core halts instead --
    the PicoRV32 precedent, and what riscv-formal's NERV does without CSRs.
    FENCE as a NOP is complete on one in-order hart with no caches.
    The decoder matches the two exact words, so CSR accesses, MRET and WFI
    stay inert. The halt resolves in EX like a branch, so a wrong-path ECALL
    is flushed, not obeyed. From then on freeze holds the pc and bubbles
    ID/EX; older instructions retire, and halt_o rises the cycle after the
    halting one leaves WB, sticky until reset. halt is a sixth bit a bubble
    clears: EBREAK's rs2 fie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
    [riscv_core.sv, riscv_decoder.sv]
2026-10-08 Run the official riscv-tests rv32ui suite: 40 of 42 pass
    riscv-tests is a submodule pinned at bcffa2b (2026-09-25). Upstream's
    env/p needs CSRs and enters tests through mret, so sw/riscv-tests-env/
    supplies this core's own riscv_test.h and link.ld: zero x1-x31, start at
    the reset vector, PASS/FAIL verbatim -- they end in ECALL, which halts.
    Test bodies and test_macros.h are untouched.
    test_riscv_tests.py assembles each test at run time with -march=rv32i
    only, so nothing outside the base set can slip in and run as a silent
    NOP, and loads the same image behind both memory ports. The list comes
    from upstream's Makefrag minus two exclusions that must still name real
    tests: fence_i (Zifencei, no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
2026-10-08 Close Phase A: every definition-of-done box passes in CI
    CI run 37817380686 on c9267af: lint clean, 164/164, all 40 rv32ui tests
    ran and passed, assembled by Ubuntu's GCC 13.2 / binutils 2.42 from the
    submodule at bcffa2b. CLAUDE.md's Phase A checklist is now fully
    checked and its status row carries the result. PROGRESS.md records it,
    renumbers Next up, and notes the ubuntu-latest move to Ubuntu 26 on
    2026-10-19, which will shift the riscv64 toolchain and the OS under the
    cached Verilator.
2026-10-08 Start Phase B: live make formal, x0 invariance proven
    The formal smoke test: one small property, proven end to end, so the
    chain -- Yosys reads the RTL, SymbiYosys drives a solver, a failure fails
    make -- is known to work before riscv-formal is in the picture.
    tb/formal/regfile_x0_formal.sv wraps the register file with every input
    free and asserts that a read of x0 returns zero on both ports. The array
    has no reset, so its initial contents are free too. regfile_x0.sby runs
    two tasks: prove (k-induction, k = 4; base case and inductive step both
    pass, so it holds in every reachable state) and cover (all four attack
    scenarios reached -- a same-cycle nonzero write and read of x0 on each
    port, a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
    [regfile_x0_formal.sv]
2026-10-08 Trap (halt) on misaligned accesses and taken targets
    riscv-formal settled the open Phase B question. Under
    RISCV_FORMAL_ALIGNED_MEM every load, store, branch and jump spec sets
    spec_trap on a misaligned address or target, and rvfi_insn_check asserts
    spec_trap == trap; without that mode it expects byte-granular success.
    Neither accepts the Phase A rule of ignoring the low bits, and assuming
    misaligned cases away would hide real behaviour from the checker. So
    they now follow the ECALL rule: an exception with no handler halts.
    Detected in EX: a load or store whose address is not a multiple of its
    size, or a taken branch or jump with target bit 1 set (JALR clears bit 0
    first; an untaken branch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
    [riscv_core.sv, riscv_mem_align.sv]
2026-10-08 Build the redirect mask by concatenation: Yosys mis-parses the cast
    The redirect target was target_sum & ~XLEN'(2'b11). Yosys 0.69 binds
    that ~ to the cast's width rather than to the cast, so the mask came
    out as 0x3, not 0xFFFFFFFC: every Yosys-built netlist jumped to
    unaligned pcs. Verilator and Vivado read it as intended, so simulation
    and synthesis never showed it. riscv-formal, which runs on Yosys, did
    on its first run (next commit) -- as would the LibreLane flow, whose
    synthesis is Yosys too.
    {target_sum[XLEN-1:2], 2'b00} needs no cast and has no precedence
    question; it was the RTL's only size cast. Bit 0 of the sum is now
    visibly unused (branch and JAL offsets are even, JALR clears i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
    [riscv_core.sv]
2026-10-08 Run riscv-formal in make formal: 42/42 checks, 42/42 covers
    riscv-formal is a submodule pinned at c992aa6. tb/formal/rvfi/ holds
    the wrapper (both memories free every cycle: any instruction stream,
    any load data) and checks.cfg: RISCV_FORMAL_ALIGNED_MEM, all 37
    checkable RV32I instructions at check cycle 15, plus reg, pc_fwd,
    pc_bwd, unique and causal at VexRiscv's 5-stage depths.
    scripts/riscv-formal.sh builds the directory layout genchecks.py
    expects as symlinks under tb/formal/build/, so the submodule is never
    written to, and runs two passes from the one config: the checks, and
    the same config with mode cover, so every cover() -- four per
    instruction, ending with "retires here, untrapped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
    [checks.cfg]
2026-10-08 Prove stall correctness by k-induction, from inside the RTL
    The first of CLAUDE.md 5.5's hand-written properties. They are about
    stall, redirect and pipeline registers, which a harness cannot reach:
    open-source Yosys turns a hierarchical reference into a new, undriven,
    free wire and drops the assertion on it. So properties now live in each
    module's `ifdef FORMAL block, beside the logic they describe, and the
    environment -- free inputs, reset on the first cycle -- stays in
    tb/formal/core_formal.sv, keeping assumptions out of rtl/.
    S1 stall and redirect never coincide; after a stall S2 pc and IF/ID
    hold, S3 ID/EX is a bubble, S4 the stall has ended. tb/formal/core.sby
    proves them by k-inducti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
    [core_formal.sv, riscv_core.sv]
2026-10-08 Prove forwarding correctness; gate reset's commits after formal finds a bug
    Forwarding (CLAUDE.md 5.5): F1/F2 assert EX's operands equal the
    architectural register values -- the youngest older writer in EX/MEM,
    else MEM/WB, else the committed value -- for every real instruction
    outside reset. L1 asserts no instruction in EX ever needs a load result
    still in flight. Proven by k-induction (holds from k = 2, run at 10)
    for one solver-chosen register (anyconst f_reg) with a shadow of its
    committed value; invariant R1 ties the shadow to the register file's
    storage, read through a new formal-only observation port on
    riscv_regfile. R1 is necessary: without it induction fails. Simulation
    tracks x1.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
    [regfile_x0_formal.sv, riscv_core.sv, riscv_regfile.sv]
2026-10-10 Prove branch-flush correctness by k-induction (B1/B2)
    "No wrong-path instruction reaches WB" as two halves. B1: a stage whose
    RVFI valid bit is clear can do nothing (no write to a nonzero rd, no
    memory access, no redirect, no halt), in ID/EX, EX/MEM and MEM/WB. B2:
    every retirement's pc is its predecessor's pc_wdata, or the reset vector
    after a reset. The valid bits are a copy of the flush logic, so B2 alone
    cannot see a design that drops the valid bit but not the instruction.
    B1 closes that gap.
    Holds from k = 7 with no helper invariant: inconsistent start states
    drain through the pipeline. Four covers reached; three planted flush
    faults caught, one of them only by B2. Netlist unchanged.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
    [riscv_core.sv]
2026-10-10 Plan first-light board bring-up before Phase C
    After Phase B's last two properties, bring the core up on the Arty A7
    (LEDs, UART text, a small C program) ahead of UVM. Record the two ways
    to program the board from WSL2, and correct vivado-setup.md: running
    openFPGALoader inside WSL still needs usbipd-win for USB access.
2026-10-14 Trim CLAUDE.md and PROGRESS.md to cut per-request token cost
    Both files are loaded on every request. PROGRESS.md drops the long
    Implemented, Not started and Decisions sections and the per-row synthesis
    commentary, keeping only what a session needs to move forward, and its
    maintenance rules now say not to log everything. CLAUDE.md keeps the build
    rules, hardware, toolchain, layout, coding, CI and commit standards; the full
    Stage 1/2 spec, phase checklists and metrics lists move to docs/buildplan.md
    under the same section numbers.
2026-10-17 Prove no structural hazard on the regfile ports (SH1)
    One write port driven only by WB and two read ports driven only by ID rule
    out port contention by construction. The one real hazard is WB writing a
    register in the same cycle ID reads it; SH1 asserts the write-first bypass
    returns WB's data on each port. Proven by k-induction (alone at k = 1),
    both covers reached at step 5. Removing the bypass fails SH1 at step 5,
    and F2 at step 6 with SH1 disabled.
    Netlist unchanged (FORMAL only): 1117 LUT / 501 FF, 103.3 MHz OOC.
    [riscv_core.sv]
2026-10-17 Prove no X into committed state, general case (XP/XT)
    Model X explicitly with Yosys xprop on the flattened core; the harness
    asserts on the commit ports' X masks.
    XP (k-induction, holds from k = 7): with the register file defined at
    power-up, nothing committed is ever X after reset -- every flop that can
    reach committed state is reset. XT (BMC, depth 10): with the register file
    X too, nothing committed is X until software reads a register it has not
    written since reset.
    Removing the reset from ex_mem_rd_we_o or halted_q fails both (steps 2
    and 4). Running opt before xprop let the optimiser fold the unreset
    halted_q to a constant and hid it, so the flow runs no opt before xprop and
    makes fr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
    [riscv_core.sv, riscv_regfile.sv, xprop_formal.sv]
2026-10-17 Add UART transmitter for first light
    8N1, transmit-only, baud set by parameter (434 clocks a bit at 50 MHz /
    115200); an elaboration check rejects a clock/baud pair more than 1% off.
    Valid/ready handshake: ready is low for exactly one frame.
    Tested at the board's parameters, bit timing checked to the clock; a
    one-clock-long bit time fails 4 of the 5 tests.
    [uart_tx.sv]
2026-10-17 Add first-light SoC and firmware, simulated whole
    soc.sv: the core, one 32 KiB dual-port RAM holding code and data (port A
    fetch, port B data, BRAM-timed), an LED register and the UART, decoded on
    address bits [31:28] and [3:2]. I/O reads are registered to arrive in WB
    like block RAM data. Board-independent, so cocotb runs it directly.
    sw/firstlight/hello.c prints a greeting and a sum, then counts on the LEDs
    forever; no libgcc, so no multiply or divide (RV32I). make fw builds a
    board image and a short-delay simulation image as $readmemh hex, with the
    local riscv32 or CI's riscv64 toolchain.
    test_soc runs the simulation image on the SoC and decodes the UART at
    115200: greeting, sum and fou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
    [bin2hex.py, hello.c, ram_dp.sv, soc.sv]
2026-10-17 Bring up the core on the Arty A7: first light
    arty_a7_top.sv: MMCM from 100 to 50 MHz, a reset held until lock plus four
    clocks (releasing from the flops' power-up 0), and the SoC. Pins from
    Digilent's master XDC; button and slow I/O false-pathed. Lint reads stand-in
    models of MMCME2_BASE and BUFG from tb/models/; Vivado never does.
    make impl (syn/impl_arty.tcl): in-context synth, route and bitstream with
    the firmware in RAM; refuses a missing RAM image and writes no bitstream if
    timing fails. Setup +5.920 ns at 50 MHz, board-level Fmax estimate 71.0 MHz
    on BRAM -> core -> BRAM, the path out-of-context could not time. 1009 LUT,
    374 FF, 8 BRAM. make prog prints the Hardware Manager steps.
    P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
    [BUFG.sv, MMCME2_BASE.sv, arty_a7.xdc, arty_a7_top.sv]
2026-10-17 Add first-light photo of the board running
2026-10-17 Program the board from WSL too: usbipd-win + openFPGALoader
    make prog now checks for the Arty's FTDI (0403:6010) in WSL: attached with
    usbipd-win, it programs with openFPGALoader -b arty_a7_100t (the 100T; plain
    "arty" is the 35T, which the setup doc had); detached, it prints the
    Hardware Manager steps as before. A udev rule (scripts/99-arty-a7.rules)
    gives plugdev the JTAG and UART interfaces. Tried on the board: programmed
    from WSL, counting read back on /dev/ttyUSB1.
    The bundled lsusb ignores -d and exits 0 with no match, so detection greps
    its listing instead.
2026-10-17 Write the Phase C functional coverage plan
    205 bins in eight groups: instructions, forwarding paths alone and
    crossed, load-use stall, control flow, corner immediates and sign
    extension, back-to-back dependencies, alignment per width, and traps.
    Defines the sources (RVFI, plus named core internals for forwarding and
    the stall), when a white-box sample counts, and the figure: bins hit over
    bins defined, so >= 95% means at most 10 unhit.
2026-10-17 Add the C golden model and check it on riscv-tests alone
    sw/model/rv32i_iss.c: an RV32I instruction-set simulator written from the
    spec, independent of the RTL and the Python model, following the core's
    documented choices (every exception halts, FENCE is a NOP, anything else
    is reported unsupported) and filling an RVFI-shaped record per step.
    make model-test assembles every rv32ui test the cocotb suite runs (same
    two exclusions) and runs each on the model alone: 40/40. A planted SRA
    bug fails exactly the sra test.
2026-10-17 Add the UVM environment; Phase C closes at 100% coverage
    tb/uvm/ in XSim: a sequence item is a program; the driver loads it into
    the testbench memory and the golden model (DPI-C) and resets the core; a
    reactive responder serves both ports with BRAM timing; the monitor turns
    RVFI into one transaction per retirement; the scoreboard steps the model
    and compares every field; the coverage collector closes against
    docs/coverage-plan.md, its own bin count cross-checked with the
    covergroups. Constrained-random programs with bounded loops, safe forward
    targets and a random trap tail.
    make uvm: 300 programs in ~45 s, 205/205 bins on seeds 1, 2 and 3, ~45k
    retirements each, 0 mismatches. Planted RTL f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
    [core_if.sv, rv_dpi.c, rv_pkg.sv, tb_top.sv]
2026-10-17 Trap illegal instructions; close Phase B
    Any word outside the 40 RV32I encodings (CSR ops, MRET, WFI, FENCE.I,
    reserved funct3/funct7, the all-zero word) now traps and halts, doing
    nothing else. It used to decode inert. Both golden models changed first,
    then the decoder; tests that pinned the inert behaviour now pin the trap.
    riscv-formal gains ill, liveness, hang and causal_mem: 46/46 checks and
    46/46 cover runs. Shown to fail on planted faults: pc_bwd and causal
    (adjacent retirements swap order labels), liveness (a stall that never
    releases), hang (a core that never starts), ill (the old inert decoder).
    No fairness assumption is needed: the memory ports cannot stall.
    Synth (OOC, 100 MHz)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
    [checks.cfg]
2026-10-17 Run CoreMark on the board: 0.962 CoreMark/MHz, IPC 0.691
    The SoC gains a 32-bit cycle counter at 0x1000_0010 (the core has no
    CSRs, so rdcycle is illegal). CoreMark is a submodule pinned at 1f483d5,
    compiled unmodified; this SoC's port is in sw/coremark-port/ (cycle
    ticks, UART console, a minimal ee_printf, CoreMark/MHz in integer
    arithmetic). `make bench` builds a 1000-iteration board image and a
    1-iteration simulation image; `make impl FW_IMAGE=...` picks the RAM
    image.
    On the Arty at 50 MHz: 1000 iterations, 1,038,847,073 cycles, 0.962
    CoreMark/MHz, "Correct operation validated" (docs/reports/
    coremark_board.txt). test_coremark runs one iteration on the whole SoC,
    checks CoreMark's CRCs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
    [core_portme.c, core_portme.h, soc.sv]
2026-10-17 Add an opt-in ILA on the pipeline registers, captured from WSL
    `make impl ILA=1` marks the core's four pipeline registers (pc and
    instruction each), the EX/MEM ALU result, writeback and halt for debug in
    arty_a7_top.sv -- soc.sv now brings them out -- and impl_arty.tcl attaches
    an ILA on the core clock (13 probes, 328 bits, depth 1024) and writes the
    .ltx. Default builds leave them open and trimmed: the committed board
    reports are unchanged (1141 LUT / 434 FF, WNS +4.917 ns), and ILA builds
    report to syn/build/board/ila_reports/ instead.
    `make ila` programs the board and captures through Vivado's Hardware
    Manager in batch -- hw_server in WSL finds the cable over usbipd -- then
    scripts/ila_c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
    [ila_capture.csv]
2026-10-17 Access data memory from EX; the board runs at 100 MHz
    At 50 MHz the board's critical path started at the data RAM's output: a
    load's data went through lane alignment, the forwarding mux and the
    branch comparator into the fetch address in one cycle (14.2 ns). Now the
    data RAM latches its address, and any store, at the end of EX (address
    from its own adder), load data arrives in MEM, and MEM/WB registers the
    aligned writeback value, so no forward starts at a BRAM output. The
    hazard unit is unchanged -- EX/MEM never forwarded load data (L1) -- and
    the load-use stall is still one cycle: CoreMark's cycles per iteration
    are identical.
    Stores issue from EX, gated by their own misalignment and by r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
    [arty_a7_top.sv, core_portme.h, riscv_core.sv, soc.sv, xprop_formal.sv]
2026-10-18 Add Vivado views, a zoomable floorplan and the Phase D screenshots
    make gui opens the last routed design in the Vivado GUI (syn/gui_view.tcl):
    device view coloured by module, worst path and its schematic, timing,
    utilization and power. VIEW=rtl shows the elaborated RTL schematic;
    VIEW=ila programs an ILA build, triggers on a function entering EX and
    shows the waveforms. The default trigger is core_state_transition: GCC
    inlines core_list_find, leaving a copy that never runs.
    make floorplan exports placement and routing from post_route.dcp
    (syn/floorplan_export.tcl) and draws them as SVG (scripts/floorplan.py):
    the whole die and a crop to the SoC, cells at their real sites, wires
    tile to tile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
    [ila_coremark.csv]
2026-10-18 Rewrite the README around what Stage 1 has built so far
    Status brought up to date (Phases A-C done, D on the board), an at-a-glance
    table, an architecture diagram, the verification layers with the two bugs
    formal caught, CoreMark's board output, the ILA captures and Vivado views,
    results with a link to the report behind each number, plain limitations,
    the real make targets and layout, and the roadmap through the Doom finale.
    soc.sv: the data port comment still said MEM/WB timing; since data memory
    moved to EX the address is taken at the end of EX and data arrives in MEM.
    [soc.sv]
2026-10-18 Add a UART receiver and a serial bootloader
    rtl/periph/uart_rx.sv: 8N1, two-flop synchroniser, start on a falling edge
    confirmed half a bit later, mid-bit sampling, one byte of buffer with
    overrun and framing-error flags. Reading it has no side effect and a write
    acknowledges: the core's data port has no read enable. In the SoC at
    0x1000_000C, status in UART ST bits 1-3, pin A9. The core is unchanged.
    sw/boot/: a bootloader in the first 4 KiB of RAM, now the default
    bitstream image. It takes "RVLD", length, CRC-32 and the image from
    scripts/load.py, runs it at 0x1000, and reruns the last good image on r.
    Programs (sw/apps/, make apps) use sw/app/ startup and sw/lib/ console I/O
    and return t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
    [arty_a7.xdc, arty_a7_top.sv, boot.c, load.py, soc.sv]
2026-10-18 Add six interactive demos on the bootloader
    sw/demo/: one program with a menu, loaded by scripts/load.py. System info
    with a RAM test and pipeline microbenchmarks (instruction blocks timed by
    the cycle counter: 1 cycle per ALU op, +1 per load-use, +2 per taken
    branch or jump, 0 not taken -- measured, on the board and in simulation);
    Mandelbrot in Q12 fixed point and soft float, with pan and zoom; pi by a
    spigot; Game of Life; Tower of Hanoi; a prime sieve with a primality
    prompt. Built -Os to fit 28 KiB with a 10 KiB scratch buffer.
    tb/cocotb/test_demo.py runs each on the whole SoC from a preloaded image
    (scripts/mkimage.py) with the UART at CLK/16, and checks the output
    against independent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
    [demo.h, hanoi.c, life.c, main.c, mandel.c, mkimage.py, pi.c, primes.c]
2026-10-18 README: the demo video, recorded on the board in PuTTY
2026-10-18 Close Phase D: the first-light photo and the demo video
    The user chose to keep the first-light photo (the board and the screens
    together) rather than retake it; with the demo video in the README that
    is the last box. Phase E starts.
2026-10-18 Add the TMR voter, formally verified
    rtl/tmr/tmr_voter.sv: bitwise 2-of-3 majority, a mismatch flag and which
    input disagrees. tb/formal/tmr_voter.sby proves for every input combination
    at W = 32 that any two agreeing inputs produce that output, that mismatch
    means exactly 'not all equal', that the flags name the odd one out, and
    that no output bit is invented; all five covers are reached. Three planted
    bugs each fail the assertion written for them.
    [tmr_voter.sv, tmr_voter_formal.sv]
2026-10-18 Triple modular redundancy: three voted cores with feedback, measured
    rtl/tmr/riscv_core_tmr.sv: three copies of the core (DONT_TOUCH,
    KEEP_HIERARCHY; synthesis fails unless three survive), one 2-of-3 voter on
    each copy's next fetch address, memory access, register write and halt
    flags, and the voted values fed back into every copy's pc, halt flags and
    register file (riscv_core's new VOTED parameter; 0 elsewhere, no change).
    Store data, write data and the data address are voted only when used: the
    core now says when it loads (dmem_re_o). A mismatch counter, counted from
    the registered mismatch to keep it off the critical path, is readable at
    0x1000_0014; the SoC takes TMR = 1, the board make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
    [arty_a7_top.sv, core_formal.sv, floorplan.py, riscv_core.sv, riscv_core_tmr.sv, soc.sv, tb_top.sv]
2026-10-18 Live fault injector: flip copy B's pc from software, demo 7
    A write to the TMR register (0x1000_0014) XORs the written bits into copy
    B's voted next pc, so B's pc flop holds a wrong value for a cycle: a real
    fault, with no change to the core. Demo 7 runs a sieve to 163840 twice,
    clean and with a random pc bit flipped every 64 marks. On the board at
    100 MHz: 14,999 primes and 3,347,320 cycles both times, 1,887 flips, all
    detected (docs/reports/tmr_inject_board.txt); simulation gives the same.
    A flip landing while a taken branch is in EX is masked (the redirect
    replaces pc + 4); with the store right before the loop branch 1,887 flips
    gave 1 detection, so the demo follows it with two nops.
    TM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
    [demo.h, main.c, riscv_core_tmr.sv, soc.sv, tmr.c]
2026-10-18 Demo 7: compact enough for CI's GCC 13
    CI's verilate job failed: Ubuntu's GCC 13.2 builds the demo reel ~100
    bytes larger than GCC 16, leaving 964 bytes of stack under the 1 KiB
    floor. Demo 7 now loops over its two runs and prints less: 1148 bytes
    left under GCC 13 (checked with Ubuntu 24.04's package), 1252 under 16.
    Same results on the board: 14,999 primes, 1,887 flips all detected,
    3,352,978 cycles clean and injected (the code moved, so the count did).
    [tmr.c]
2026-10-18 Demo 7 repeats until a key: totals live on screen and LEDs
    The sieve runs once clean, then injected pass after pass, the table's
    injected row rewritten after each (outside the timed region: waiting on
    the UART would make the cycles differ); LD4-LD7 show disagreements / 4096.
    On the board at 100 MHz: 133 passes in about 5 s, every one 14,999 primes
    and 3,354,864 cycles, as the clean run; 250,971 flips, all detected
    (docs/reports/tmr_inject_board.txt). Simulation gives the same per pass.
    flips and detected are reset on entry: a second run of the demo started
    from the first run's counts (seen on the board; the test runs it once).
    Stack room: 1160 bytes under GCC 16, 1060 under CI's GCC 13.2 (c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
    [tmr.c]
2026-10-18 README: video of demo 7 injecting faults on the board
2026-10-18 README: the demo 7 video's caption names the LEDs
2026-10-18 CI: pin both jobs to ubuntu-24.04
    ubuntu-latest becomes 26.04 on 2026-10-19. Its gcc-riscv64-unknown-elf
    15.3 ships no stdint.h without picolibc (not installed: no recommends),
    so every firmware build would fail; checked with the unpacked .debs.
2026-10-18 make asic: LibreLane run #1 on the bare core, Sky130
    LibreLane 3.0.16 (nix-shell), classic flow, riscv_core alone at 25 ns,
    sky130_fd_sc_hd, block-level, register file as flops, slang frontend
    (Yosys 0.62's reader rejects `parameter string` in the board top, and
    every .sv under rtl/ is read). scripts/asic_summary.py writes
    docs/reports/summary_asic.txt from the run's metrics.
    Measured: die 227,997 um^2, 13,168 standard cells (1,496 flops), 58.2%
    utilization, 6.42 mW typical; Magic/KLayout DRC, LVS and antenna clean.
    Setup meets at typical (+7.751 ns, 58.0 MHz) but fails at the slow corner
    by 4.679 ns (33.7 MHz worst, I/O included): all 90 violations are the
    fetch-address output path, the FP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
    [asic_summary.py]
2026-10-18 ASIC run #1: KLayout layout screenshots
    docs/img/asic/run1/layout.png (whole block) and layout-zoom.png (single
    standard cells with li1/met1 wiring), met4/met5 power grid hidden. The
    unreadable auto render is dropped and asic_summary.py no longer copies it.
    asic_summary.py now merges the steps' config.json copies instead of
    reading resolved.json, which LibreLane rewrites when the run is opened
    with --last-run --flow openinklayout. Reports regenerate byte-identical.
    [asic_summary.py]
2026-10-19 make asic at 35 ns: still fails at max_ss, by 0.97 ns
    Relaxing the clock made every slow-corner path slower: the resizer
    buffers fanout and I/O with clkdlybuf4s25_1, a clock delay cell (1.2-2.4
    ns per stage at ss); the worst imem_addr_o path passes seven of them.
    Reports and a trend row as measured; the 25 ns reports stay at 59b60a9.
2026-10-19 make asic: run #1 closes at 35 ns, all 9 corners
    With the clock delay cells excluded, 35 ns meets setup (+3.502 ns,
    max_ss, imem_addr_o) and hold (+0.102 ns) at every signoff corner, DRC,
    LVS and antenna clean: 31.7 MHz worst case including the 20% I/O budget,
    46.2 MHz register-to-register, 119,277 um^2 of cells, 4.60 mW at tt.
    3,091 max-slew violations remain, recorded as open. Run #1 checked off
    in the buildplan.
2026-10-19 README: Phase E done, Stage 1 complete
    A new "As a chip (Sky130)" section with the KLayout screenshots and how
    run #1 was closed; the ASIC results table filled for run 1 from
    summary_asic.txt; at-a-glance, status, limitations, build and roadmap
    updated. Phase E marked done in CLAUDE.md and PROGRESS (TMR Vivado
    screenshot set waived by the user).
2026-10-19 Phase E Vivado screenshots: the TMR core beside Phase D
    docs/img/vivado/phase-e/: device view by copy, zoomed to the voter,
    worst path (device and schematic: it ends in the voter's mismatch
    detector), timing, utilization with three equal copies, the TMR core and
    voter RTL schematics, and the TMR floorplan pair. The Phase D set is
    untouched; README "In Vivado" now shows the two side by side.
2026-10-19 Phase F: systolic PE, verified exhaustively against the golden model
    rtl/accel/systolic_pe.sv: signed INT8 x INT8 plus an INT32 partial sum,
    activation passed right and sum passed down, both registered; weights
    double-buffered so the next tile's weights shift in during compute.
    test_systolic_pe runs all 65,536 (activation, weight) pairs back to back
    against gemm_model.pe, with psums at both INT32 limits and weight swaps
    with no idle cycle. Linted as its own top.
    [systolic_pe.sv]
2026-10-19 Phase F: systolic array, bit-exact against the golden model at 3 sizes
    rtl/accel/systolic_array.sv: ROWS x COLS PEs with input skew and output
    deskew, so a row of A enters as one vector and its results leave as one
    vector ROWS + COLS - 1 edges later. The weight swap now travels with the
    data (systolic_pe w_swap_o), so each PE switches exactly after the
    tile's last row has passed it.
    test_systolic_array plays feeder and output buffer: 2,000 / 1,000 /
    2,000 random GEMMs at 4x4 / 16x16 / 4x8, edge shapes and saturation
    jobs, every element against gemm_model.gemm and every row's latency
    checked. Four planted array bugs caught.
    [systolic_array.sv, systolic_pe.sv]
2026-10-19 make synth-array: the 16x16 array out of context, MACs land in LUTs
    syn/synth_ooc.tcl takes systolic_array <rows> <cols>; make synth-array
    ARRAY=16x16. First run: Vivado maps all 256 MACs to LUT fabric (28,545
    LUT, 45% of the device, 0 DSP), 104.6 MHz. Reports and a new
    append-only table in PROGRESS.
2026-10-19 README: Phase F, the systolic array
    A Systolic array section: the dataflow, golden model first, two MACs per
    DSP and why the spacing is 16, the LUT-vs-DSP synthesis table, and the
    verification. At a glance, status, the Stage 2 results row for DSP vs.
    LUT MACs, build targets and layout updated; make sim is 320/320 across
    24 entries. Phase F marked done in CLAUDE.md. The DMA comes from the
    user's other project (PROGRESS, carried forward).
2026-10-22 Plan: M after Phase G, tiny-LLM demo, DMA driver and FPGA-vs-ASIC notes
    - buildplan: M extension (RV32IM, off by default) as Phase H's first
    item, for the tiny-LLM demo and Doom; A/F/D/C stay out of scope.
    Written FPGA-vs-ASIC comparison added as a Phase H checkbox.
    - CLAUDE.md: ISA rule allows M after Phase G.
    - PROGRESS: the user's other project is the DMA's driver (QEMU), not
    its RTL; tiny-LLM demo (llama2.c stories260K); M plan, and the README
    must say M was first ruled out and added later.
2026-10-25 Phase F Vivado screenshots: the 16x16 array, make gui VIEW=array/pair
    VIEW=array opens the committed make synth-array checkpoint coloured by
    array row (no row yellow, the worst path's colour), with the worst path,
    timing and hierarchical utilization; VIEW=pair elaborates one PE pair.
    The set goes in docs/img/vivado/phase-f/, beside phase-d/ and phase-e/,
    and the README gets its own section: the array is out of context, not
    comparable with the board builds.
    Read off the routed netlist: AREG = 1 on all 128 DSPs (the packed weight
    lives in the A register), BREG = 2 on 125, MREG = PREG = 0.
2026-11-03 DMA-Engine as a submodule: the Phase G register map, model and trace
    sw/dma-engine at 3dcf38a: spec/dmaeng.yaml is the single source of truth
    for the DMA's registers and descriptors, qemu-device/dmaeng.c the
    behavioural model, traces/dmaeng-sync.trace the golden stimulus. README
    links the project where it is used.
2026-11-03 buildplan: DMA to DMA-Engine's spec; clk_array, CDC and releases as boxes
    6.3 follows DMA-Engine's descriptor ring instead of the linked list first
    planned, with this SoC's 32-bit addresses and no interrupts. Phase G gains
    the DMA-Engine verification path and the soc-v1.0 release; Phase H the
    array clock domain with CDC, the different-clock regression and GEMM test,
    the weight-transform hook, MMCM DRP registers and soc-v2.0, matching the
    release tests in fpga-coord's dependencies.toml.
2026-11-03 Keep DMA.md local (gitignored)
2026-11-03 DMA golden model: dmaeng.c ported to Python, golden trace replayed
    Phase G starts with the model, before any RTL. sw/model/dmaeng_model.py
    ports DMA-Engine's QEMU device (synchronous mode) and reads every offset,
    bit and limit from its generated dmaeng_regs.h. Replaying
    traces/dmaeng-sync.trace matches all 923 register accesses and 280
    descriptors record for record.
    The trace's Linux driver always clears IRQ_STATUS, reprograms after a
    reset and keeps one descriptor in flight, so four of the first five
    planted bugs passed the replay. Directed checks from the spec text cover
    those: one MSI per rising edge, the MAX_XFER boundary, HEAD after owned
    and unowned errors, reset clearing every regist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
2026-11-04 DMA register slave: AXI4-Lite + DMA-Engine's register file, against the model
    rtl/bus/dmaeng_regs.sv: the AXI4-Lite slave and the register file of
    DMA-Engine's map, offsets and bits from its generated dmaeng_pkg (read from
    the submodule, prepended to every source list). Semantics follow dmaeng.c
    via sw/model/dmaeng_model.py: BUSY is has_work, CTRL.RESET clears all and
    wins over engine reports, IRQ_STATUS is W1C with a same-cycle set winning,
    HEAD wraps by RING_SIZE - 1, irq_o is the level. Partial-strobe writes are
    ignored with SLVERR (registers are 32-bit only). The descriptor engine will
    sit behind run_o / head_adv_i / done_irq_i / err_i, never seeing AXI.
    test_dmaeng_regs: every read, ir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
    [dmaeng_regs.sv, dmaeng_regs_check.py]
2026-11-04 DMA engine: descriptor sequencer + byte-granular AXI4 master, trace replays
    rtl/bus/dmaeng.sv joins dmaeng_regs to two new blocks:
    - dmaeng_desc: walks the ring in the order of DMA-Engine's QEMU device
    (ring checks, fetch, OWN, rsvd, len, range, copy, status then flags,
    HEAD, error or completion). It issues commands, never bus signals.
    - dmaeng_axi: the AXI4 master. 32-byte descriptor fetch, word writes, and
    copies at any byte alignment (funnel shift by (src - dst) mod 4, strobes
    at the ends) in chunks of at most 64 bytes that never cross 4 KiB. AW and
    W rise together; CTRL.RESET lets the burst in flight finish, then nothing.
    test_dmaeng runs the model beside the RTL behind a stal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
    [dmaeng.sv, dmaeng_axi.sv, dmaeng_desc.sv]
2026-11-05 Core data-port wait (MEM_WAIT): dmem_ready_i holds the whole core
    Decided with the user for Phase G: the core can wait for a memory access,
    so peripherals can sit behind a real AXI4-Lite bus at any latency, as the
    array's CDC (Phase H) and DDR + cache (the Doom finale) will need. Behind
    a parameter defaulting off, so every Stage 1 result stays valid: with
    MEM_WAIT = 0 dmem_ready_i is ignored and synthesis gives the same cells.
    With MEM_WAIT = 1, dmem_ready_i low is a whole-core clock enable: every
    pipeline register, the pc, halt flags and RVFI shadows hold; stores,
    loads, register writes and retirements are gated; fetch re-presents pc.
    A held cycle is an edge that never happened, so forward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
2026-11-05 DMA on the SoC: AXI4-Lite bridge, RAM port sharing, bare-metal driver
    soc.sv builds the core with MEM_WAIT. Region 0x2000_0000 goes through
    core_axil_bridge (an AXI4-Lite master that holds the core per access,
    one in flight, in program order; errors set BUSERR at 0x1000_0018) to the
    DMA engine's registers. The engine's AXI4 master reaches the RAM through
    port B via axi_ram_port, only in cycles the core issues no load or store,
    so the core keeps fixed priority and never waits for the DMA. The
    read-data selects move only when the core advances.
    sw/lib/dma.{h,c}: the bare-metal driver on DMA-Engine's generated
    dmaeng_regs.h (https://github.com/RodeanAzari/DMA-Engine), struct offsets
    checked ag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
    [axi_ram_port.sv, core_axil_bridge.sv, soc.sv]
2026-11-05 TMR: register the bundles before the mismatch compare
    The diagnostic mismatch counter compared the three copies' next-state
    bundles straight off their EX logic: copy -> compare -> flop, 22 levels,
    the TMR critical path since Phase E. With the AXI crossbar in the SoC the
    TMR board missed 100 MHz on it (WNS -0.260 ns). The bundles are now
    registered, then compared and registered: the board meets 100 MHz at
    +0.123 ns (4,944 LUT, 2,975 FF, +429 FF); out of context 104.5 MHz
    (was 101.4), 107.7 with MEM_WAIT (was 99.5, failing).
    The count now lags mismatch_o by two cycles; the vote, mismatch_o and
    disagree_o are unchanged, and demo 7 judges detection at the next flip.
    Every TMR entry rerun: core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
    [riscv_core_tmr.sv]
2026-11-05 GEMM accelerator on the bus, launched by software on the core (Phase G)
    gemm_accel: the 16x16 systolic array with local A/W/C buffers (16 KiB
    each, banked so the array reads a line a cycle), filled and emptied by
    the DMA; a sequencer runs a whole C = A @ W tiled in hardware (N outer,
    K inner, INT32 sums along K in C, zeros past K and N); AXI4-Lite
    registers (START, STATUS, M/K/N, CYCLES) and an AXI4 buffer port that
    waits while a job runs. Shapes over any buffer are refused.
    Golden model first (sw/model/accel_model.py, make accel-model): layouts,
    limits, and the cycle count as a contract. test_gemm_accel at 4x4, 4x8
    and 16x16 against it, byte-exact C, exact CYCLES; 10 planted bugs caught.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
    [gemm_accel.sv, gemm_accel_regs.sv, gemm_accel_seq.sv, soc.sv]
2026-11-05 Move trend tables and design notes into tracked docs
    docs/measurements.md holds every trend table (synthesis, board, TMR cost,
    array, DMA, accelerator, ASIC, CoreMark) and the verification detail;
    docs/design-notes.md holds per-block implementation notes, toolchain, CI,
    build targets and decisions. Both were in the untracked PROGRESS.md, so the
    README's links to the trend tables were dead on GitHub; they now point here.
    Tables copied verbatim, still append-only.
2026-11-06 Release soc-v1.0: CHANGELOG, release-test evidence
    fpga-coord release test for soc-v1.0 ("Phase G: AXI interconnect + DMA;
    AXI SVA properties proven"): lint, dma-model, cocotb 18/18 (DMA register
    slave, DMA engine, crossbar, test_dma on the single and TMR SoC), the
    crossbar's properties by k-induction with all covers reached. Closes
    Phase G's last box.
2026-11-06 dmatest and gemmtest on the board, single core and TMR
    Bitstreams rebuilt from f873d7d (make impl, make impl TMR=1; reports
    identical but for dates). dmatest 186/186 and gemmtest 11/11 on both,
    every cycle count equal to simulation's. Logs in docs/reports/.
2026-11-06 Phase G floorplan: the whole SoC, accelerator, DMA and AXI coloured
    make floorplan from the single-core board build (f873d7d RTL, WNS +0.288 ns):
    the accelerator, DMA engine and AXI glue get their own colours in the SVG
    and in make gui's device view. The SoC reset's routing (~370 KB) now
    exceeds csv's default field limit, so the reader raises it. The README's
    floorplan switches to the SoC; Phase D and E floorplans stay linked. Copies
    in docs/img/vivado/phase-g/. Each SVG is 16.5 MB (Phase E's: 4.2 MB).
    [floorplan.py]
2026-11-06 Phase G Vivado screenshot set and its README section
    The single-core board build of the soc-v1.0 RTL (WNS +0.288 ns): device
    view coloured by block, one slice, the worst path inside a PE pair, timing,
    utilization by module, the vectorless power estimate, and the elaborated
    SoC, DMA engine, crossbar and accelerator. Phases D-F's sets unchanged.
2026-11-06 M extension golden models: Python and C, checked against spike
    Both models gain an M switch that defaults off, so RV32I behaviour (M
    encodings trap) and every Stage 1 result are unchanged. With it on they
    execute MUL/MULH/MULHSU/MULHU/DIV/DIVU/REM/REMU, with the spec's results
    for division by zero and INT_MIN / -1.
    scripts/m_vectors.py runs 10,592 vectors (all pairs of 18 edge values
    plus 1,000 seeded random pairs, through all 8 ops) on spike --isa=rv32im
    and commits the results as sw/model/m_vectors.txt, so the check needs no
    spike. make model-test now also runs riscv-tests rv32um on the C model
    and both models against the vectors.
    Verified: make model-test: rv32ui 40/40 (M off), rv32um 8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
2026-11-06 M extension unit: riscv_muldiv, alone, simulated and proven
    rtl/core/riscv_muldiv.sv, not yet in the core. MUL*: operands captured,
    sign/zero-extended to 33 bits, four 17x17 signed partial products
    registered (4 DSP48E1), summed: 3 cycles in EX. DIV*: |a|, |b|
    captured, 32 restoring steps, signs applied: 34 cycles, fixed.
    Handshake valid_i / done_o / ack_i, result held until ack (MEM_WAIT).
    Verified:
    - make lint clean (unit linted plain, FORMAL+MULDIV_ARITH at XLEN 32
    and 8).
    - riscv_muldiv:test_muldiv: all 10,592 spike vectors and 3,000 random
    ops against the golden model, operands scrambled after capture,
    random ack delays, reset mid-op; latency exact.
    - tb/formal/muldiv.sby: k-indu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
    [muldiv_formal.sv, riscv_muldiv.sv]
2026-11-07 M extension in the core: M_EXT parameter, stall in EX, riscv-formal ALTOPS
    riscv_core gains M_EXT (default 0: M encodings stay illegal, no unit, RV32I
    results unchanged -- same cells and timing, reports identical). With
    M_EXT = 1 the decoder raises muldiv for funct7 0000001 under OP; riscv_muldiv
    sits in EX, captures the forwarded operands on the first cycle, and while it
    works IF/ID/EX hold and a bubble enters MEM (mstall); the result leaves EX
    like an ALU result. ack = done && !hold.
    Formal (core.sby, bitwuzla, unit replaced by muldiv_stub.sv): M1-M4, I1, B3
    and F1/F2 against first-cycle operands; prove_m, cover_m, prove_m_wait,
    cover_m_wait pass. M4 (a result ready during a hold survives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
    [checks_m.cfg]
2026-11-07 UVM with M: RV32IM build, M in the generator, coverage group 9
    make uvm M=1 elaborates tb_top with M_EXT = 1 (its own snapshot and log);
    tb_top hands the parameter to the environment through the config DB, which
    turns the C model's M switch on (rvm_set_m), adds K_M to the generator
    (corner operands set just before now and then: x / 0, INT_MIN / -1) and
    counts coverage group 9 (33 bins, written into coverage-plan.md first).
    Group 1 no longer counts M encodings as ADD..AND. Forwarding is sampled on
    an instruction's first EX cycle only: an M instruction stays in EX while ID
    and the bypass probe move on.
    Verified: make uvm M=1 238/238 bins on seeds 1, 2, 3 (~45-46k retirements
    each, 0 mismatche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
    [core_if.sv, rv_dpi.c, rv_pkg.sv, tb_top.sv]
2026-11-07 TMR with M: M_EXT through the wrapper, fault campaign on RV32IM
    riscv_core_tmr passes M_EXT to all three copies (default 0: RV32I TMR
    reports unchanged). The fault campaign on the M build (riscv_core_tmr_m,
    make faults M=1) runs RV32IM programs with the model's M on, budgets 34
    cycles per M instruction, and adds the M unit's flops to the targets and
    to the end-of-trial comparison; the flop parser now skips ifdefs nested in
    FORMAL blocks (it picked up two formal-only flops of the unit). make
    synth-m builds the TMR core too, and the per-hierarchy report is named per
    build (it was a fixed name, so _wait and _m runs overwrote RV32I's).
    Verified: make faults M=1, 10,000 flips, 0 failures, 1,027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
    [riscv_core_tmr.sv]
2026-11-07 RV32IM on the SoC and board build: M_EXT through soc/top/impl, CoreMark M
    soc.sv and arty_a7_top.sv take M_EXT (default 0) to the core or the TMR
    core; make impl M=1 builds it, reports *_board[_tmr]_m.*. make bench also
    builds coremark_m{,_sim}.hex, -march=rv32im, 5000 iterations on the board
    image (2.6x faster per iteration than RV32I; 2000 would run under
    CoreMark's 10 s minimum). soc_m / soc_tmr_m run test_coremark on the M
    image, report coremark_m_sim.txt.
    Verified: soc_m:test_coremark and soc_tmr_m:test_coremark pass (CRCs,
    TMR zero mismatches): 284,853 instructions in 399,865 cycles, IPC 0.712,
    2.501 CoreMark/MHz for one iteration (RV32I 0.963, rerun here unchanged:
    1,038,833 cycles).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
2026-11-07 CoreMark RV32IM on the board: 2.500 CoreMark/MHz at 100 MHz
    make impl M=1 FW_IMAGE=sw/build/coremark_m.hex, make prog, UART captured:
    5000 iterations, 1,999,390,615 cycles, "Correct operation validated",
    CRCs as published; about 250 CoreMark at 100 MHz (RV32I 0.962/MHz, 96).
    399,878 cycles per iteration on the board against 399,865 in simulation
    (soc_m:test_coremark), 0.003%. The port's banner says rv32i (hard-coded);
    the flags line, -march=rv32im, is the build's.
2026-11-07 TMR RV32IM on the board: 100 MHz met, CoreMark cycle-identical
    make impl M=1 TMR=1 FW_IMAGE=sw/build/coremark_m.hex: three voted cores,
    each with its M unit, 16,891 LUT / 14,305 FF / 143 DSP (131 + 3 x 4),
    100 MHz met with WNS +0.181 ns. On the board: CoreMark 5000 iterations,
    1,999,390,615 cycles -- identical to the single RV32IM core -- 2.500
    CoreMark/MHz, "Correct operation validated".
2026-11-07 xprop with M (XT bounded; XP open) and the README's M section
    xprop.sby gains bmc_m and cover_m: the core built with M_EXT and the real
    unit, whose datapath registers are unreset by design. XT passes to depth
    10 from reset, and a new cover (harness parameter M) reaches an M
    instruction retiring with everything defined. XP by induction with M does
    not close: an induction start with X on a control flop (id_ex_muldiv, so
    mstall X) holds the pipeline for any window, so it needs a "no reset flop
    is X" invariant the port-only harness cannot state (tried depth 10 and
    24, real unit and stub); recorded as open, not as a pass.
    README: M extension section (first ruled out, added for the LLM and Doom;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
    [xprop_formal.sv]
